Gregification/cse-labs/cse3442 embedded 1/readme.txt

cse3442 Embedded Systems 1, Professor Losh
fall2024,
