Gregification/cse-labs/homelab/kicad/README.txt

sources & breif instructions for everything in the libraries folder
	clone the github / gitlab ones

https://github.com/Digi-Key/digikey-kicad-library
https://gitlab.com/kicad/libraries/kicad-symbols
https://gitlab.com/kicad/libraries/kicad-footprints
