Gregification/cse-labs/cse4352/cse4352_spring2025_project1/src/uart_interface/readme.txt

the files in the uart interface folder are baselined off my (George Boone, 1002055713) embedded 1 lab 4.
