Gregification/cse-labs/homelab/mspm0l1306fiddle/SD ADC logger/src/FatFs/readme.txt

FatFs is a storage interface library.
	web page :		http://elm-chan.org/fsw/ff/
		
Version used : FatFs Module Source Files R0.15

this is a port of FatFs to the MSPM0L1306 MCU.

SD spi info : http://elm-chan.org/docs/mmc/mmc_e.html#spimode
	- CS active low
	- MOSI idle high
	- MISO idle high
	- CLK idle low
