Gregification/cse-labs/cse3341 digital logic design 2/dld2_lab5/cse3341_fall2024_lab5_GeorgeBoone.pdf

CSE 3341 | George Boone 1002055713 | submitted 10/18/2024

# Lab 5 report

## Contents

“Check your understanding” | 1
Simulation Results (8 bit) | 1
Test Results (5 bit) | 4
Pin Assignments | 7
Verilog Code | 10

Note : if you are to build the Quartus project there is a “N” macro defined at the top of the “lab5.sv” file, changing that changes the number of bits handled. E.g : “`define N 8” for 8 bit.

## “Check your understanding”

A : The circuit uses the fact that taking the 2’s complement of a number gets its negative value to find the difference, then because the highest carryout indicates A is less than B and so the result is negative, another 2’s comp conversion can be done to flip the sign of the negative result.

B : cout high indicates value A was less than value B. since the carries are effectively ‘borrows’ so it's just the same as having an extra ‘borrow’. cout low indicates A is greater than B since it was able to satisfy all the ‘borrows’.

## Simulation Results (8 bit)

context: A & B values are input from switches, loaded on button press. Switch 9 is held high to show results, but is not part of the input value. Red LED9 indicates Cout.

| A | B | R = | A - B | | Cout
a | 01010101 | 10101010 | 01010101 | 0
b | 01111111 | 00000001 | 01111110 | 1
c | 01111111 | 11111111 | 10000000 | 0
d | 01100110 | 11011101 | 01110111 | 0

e | 11111111 | 00000000 | 11111111 | 1
f | 00000000 | 11111111 | 11111111 | 0
g | 10101010 | 01010101 | 01010101 | 1
h | 11111111 | 11111111 | 00000000 | 1

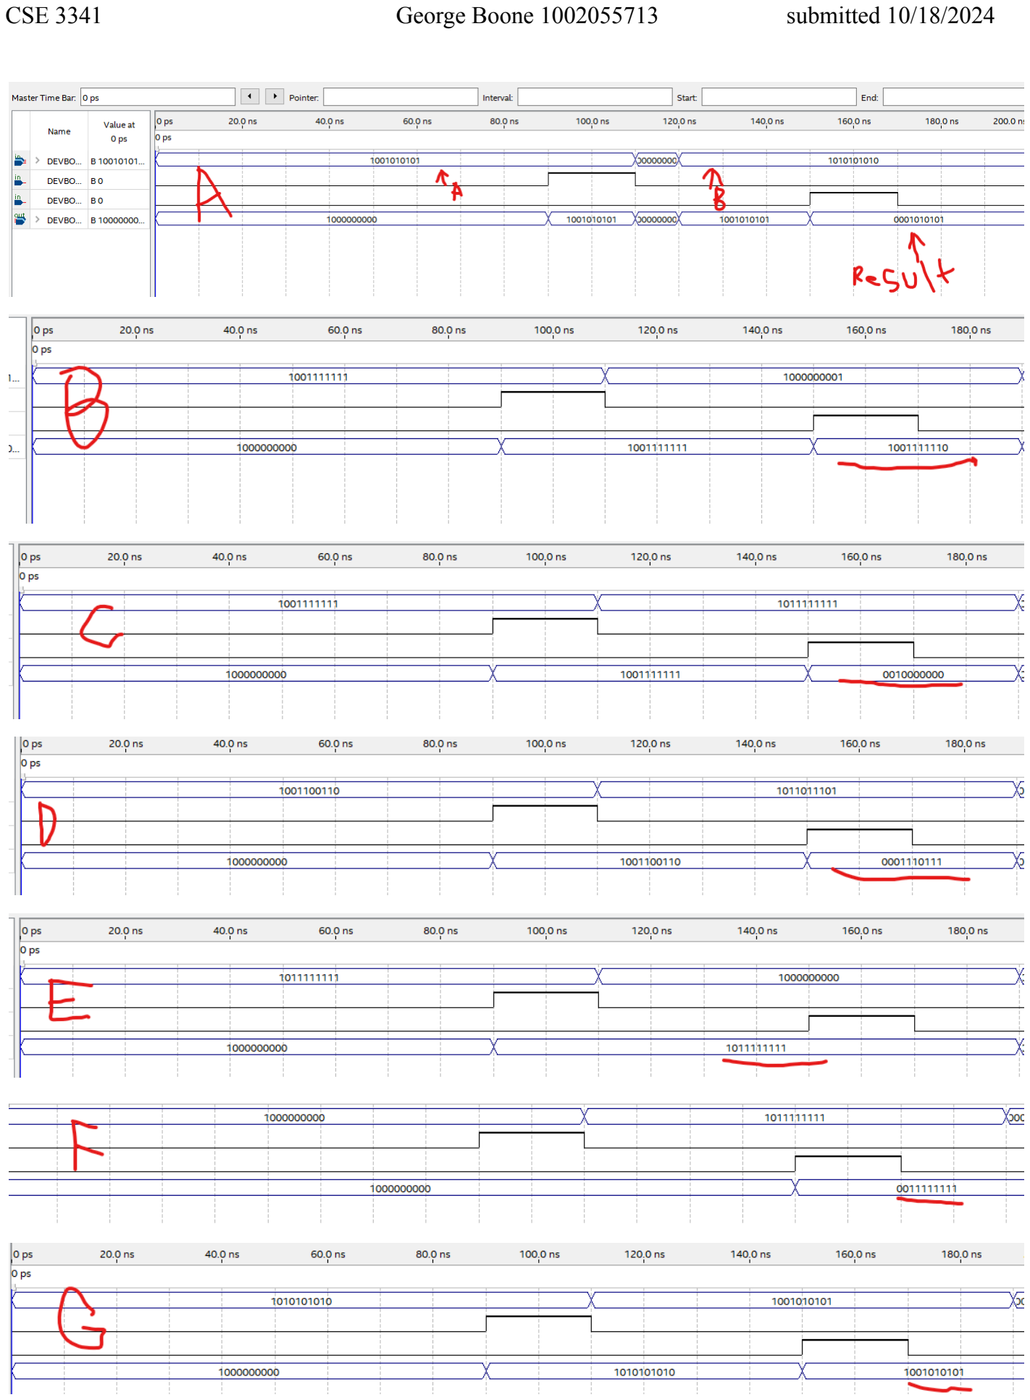
[picture p6: page 3]

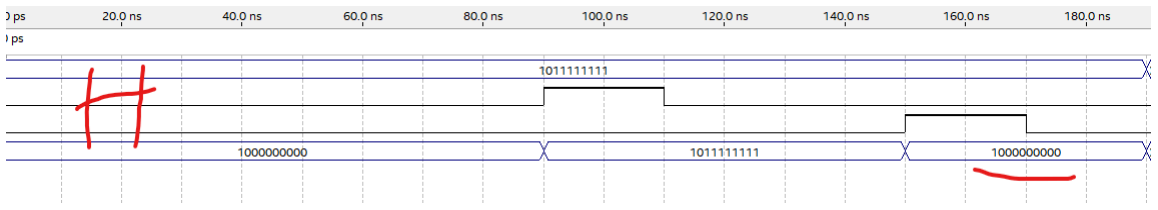
[picture p7: figure]

## Test Results (5 bit)

5-bit results recording : https://youtu.be/OHLeVnUSI3M

| A | B | R = | A - B | | cout
a | 10101 | 01010 | 01011 | 1
b | 01010 | 10101 | 01011 | 0
c | 11111 | 00001 | 11110 | 1
d | 00001 | 11111 | 11110 | 0
e | 10110 | 00000 | 01101 | 1
f | 10110 | 10110 | 00000 | 1

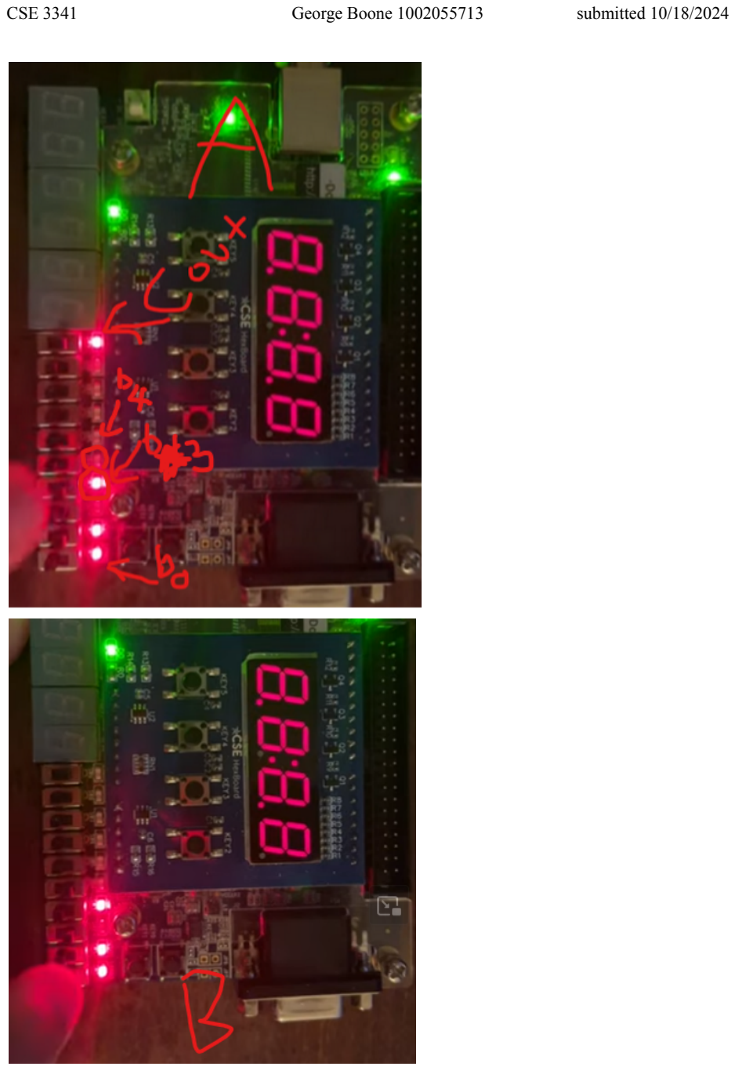
[picture p8: page 5]
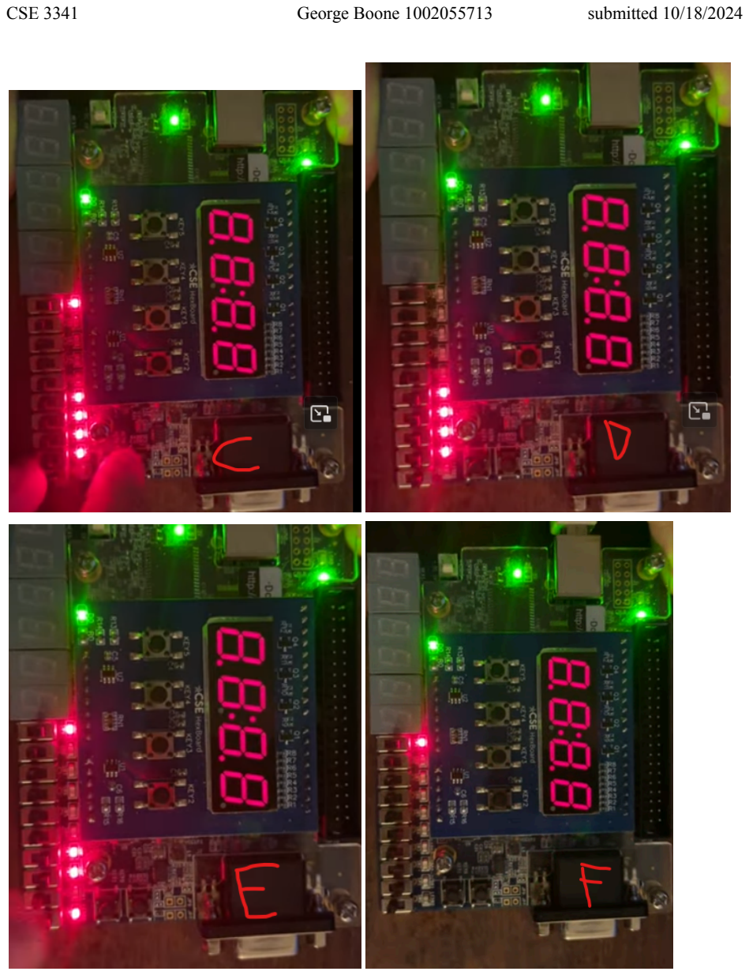
[picture p9: page 6]

## Pin Assignments

effective assignments (from top level of lab module)

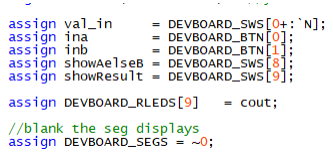
[picture p10: figure]

Actual

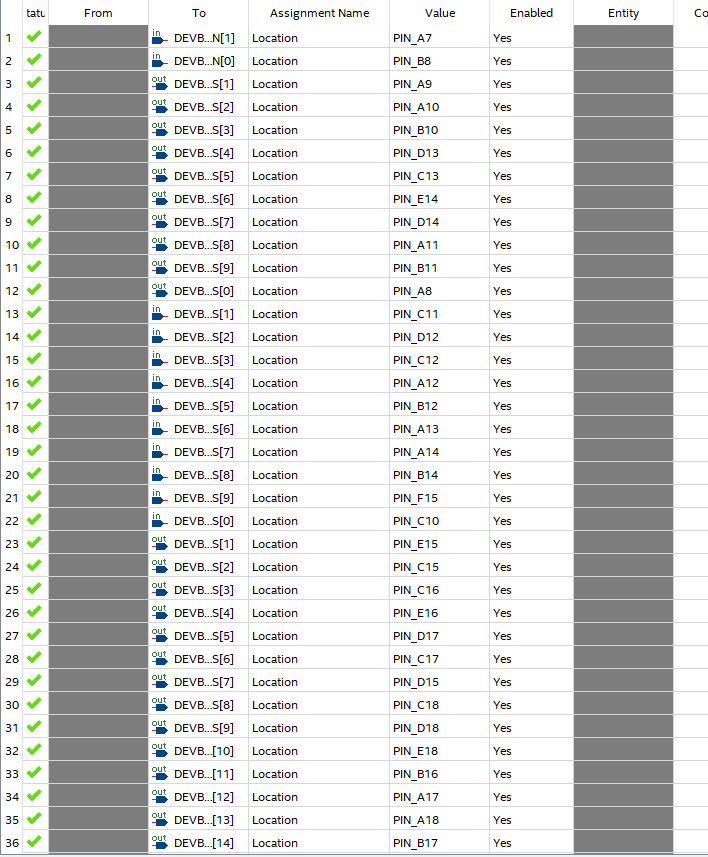
[picture p11: figure]

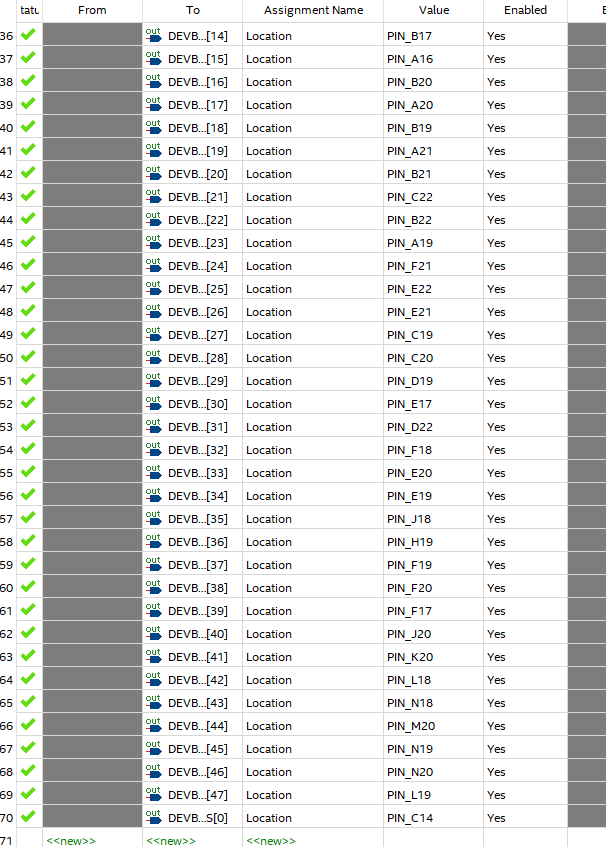
[picture p12: figure]

## Verilog Code

Top level lab

/**
cse3341, digital logic 2, lab 5 George Boone
1002055713

modular exponent subtractor
this module is not part of the logic, it only serves to demo it */

`define N 8

module lab5(
// standard in. i got tired of the assignment editor, see immideatly after wire decelerations for assignments
input [9:0] DEVBOARD_SWS,
input [1:0] DEVBOARD_BTN,
output[9:0] DEVBOARD_RLEDS, output[47:0]DEVBOARD_SEGS
);

//------------------------------------------------------------------------------// INPUT ASSIGMENTS \ EXTERNAL WIRING //------------------------------------------------------------------------------

wire [`N-1:0] val_in;
wire ina, inb;
wire cout;
reg showAelseB, showResult; //yeah

assign val_in = DEVBOARD_SWS[0+:`N];
assign ina | = DEVBOARD_BTN[0];
assign inb | = DEVBOARD_BTN[1];
assign showAelseB = DEVBOARD_SWS[8]; assign showResult = DEVBOARD_SWS[9];

assign DEVBOARD_RLEDS[9] = cout;

//blank the seg displays
assign DEVBOARD_SEGS = ~0;

//------------------------------------------------------------------------------// INTERNAL WIRING
//------------------------------------------------------------------------------reg [`N:0] valA, valB, diff;

always @ (posedge ina)
valA = val_in;

always @ (posedge inb)
valB = val_in;

always @ (showAelseB, showResult) if(showResult == 1)
DEVBOARD_RLEDS[0+:`N] = diff; else if(showAelseB == 1)
DEVBOARD_RLEDS[0+:`N] = valA;
else
DEVBOARD_RLEDS[0+:`N] = valB;

//------------------------------------------------------------------------------
// MODULES
//------------------------------------------------------------------------------

//there is a bug where valA and/or valB are updated when flicking around the switches. // i

//works
// | RCSubtractor(
// | .A(valA),
// | .B(valB),
//
// | .D(diff),
// | .COUT(cout)
// | );

//works
// | BintTwosComp(
// | .BIN(valA),
//
// | .TWOSCOMP(diff),
// | .COUT(cout)
// | );
| ExponentSubtractor#(
| .N(`N)
| )(
| .EA(valA),
| .EB(valB),
| .Cout(cout),
| .ED(diff)
| );

endmodule

Top level exponent subtractor

/**
cse3341, digital logic 2, lab 5
George Boone
1002055713

hardcoded exponent subtractor according to figure 1 of lab document */

module ExponentSubtractor#(
parameter N = 8
)(
input [N-1:0] EA, EB,
output Cout,
output [N-1:0] ED
);

wire [N-1:0] d, invd; // difference, inverted-difference

RCSubtractor #(
.N(N)
) | _rcs | (
.A(EA),
.B(EB),

.D(d),
.COUT(Cout)
);

Mux2t1 #(
.N(N)
) _m2t1 (
.CTRL(Cout),
.A(invd),
.B(d),

.OUT(ED)
);

BintTwosComp #(
.N(N)
) _bttc (

.BIN(d),

.TWOSCOMP(invd)
);

endmodule

Full adder

/**
cse3341, digital logic 2, lab 5 George Boone
1002055713
*/

module FullAdder(
input A, B, CIN,
output S, COUT
);

wire axb;

assign axb = A ^ B;

assign S = axb ^ CIN;
assign COUT = ((axb) & CIN) | (A & B);

endmodule

Ripple carry subtractor

/**
cse3341, digital logic 2, lab 5 George Boone
1002055713

accepts 2 raw binary nums
*/

module RCSubtractor#(
parameter N = 8
)(
input [N-1:0] A, B,
output [N-1:0] D,
output COUT

);

wire [N-1:0] _carries;

assign COUT = _carries[N-1];

// ripple carry design
genvar i;
generate
for(i = N-1; i >= 0; i = i-1) begin : adder_array FullAdder _fa(
.A(A[i]),
.B(~B[i]),
.CIN(i == 0 ? 1 : _carries[i-1]), .S(D[i]),
.COUT(_carries[i])
);
end
endgenerate

endmodule

2 to 1 multiplexer

/**
cse3341, digital logic 2, lab 5 George Boone
1002055713
*/

module Mux2t1#(
parameter N = 8
)(
input CTRL, | // 0:A, 1:B
input [N-1:0] A, B,
output wire [N-1:0] OUT
);

assign OUT = CTRL ? B : A;

endmodule

Binary to 2’s complement converter

/**

cse3341, digital logic 2, lab 5 George Boone
1002055713
*/

module BintTwosComp#(
parameter N = 8
)(
input [N-1:0] BIN,
output reg [N-1:0] TWOSCOMP,

// debug
output reg COUT
);

wire [N-1:0] _carries;

assign COUT = ~_carries[N-1];

// ripple carry design
genvar i;
generate
for(i = N-1; i >= 0; i = i-1) begin : adder_array FullAdder _fa(
.A(~BIN[i]),
.B(0),
.CIN(i == 0 ? 1 : _carries[i-1]), .S(TWOSCOMP[i]),
.COUT(_carries[i])
);
end
endgenerate

endmodule
