Gregification/cse-labs/cse2441/cse2441_labs/FullAdder/Full page photo.pdf

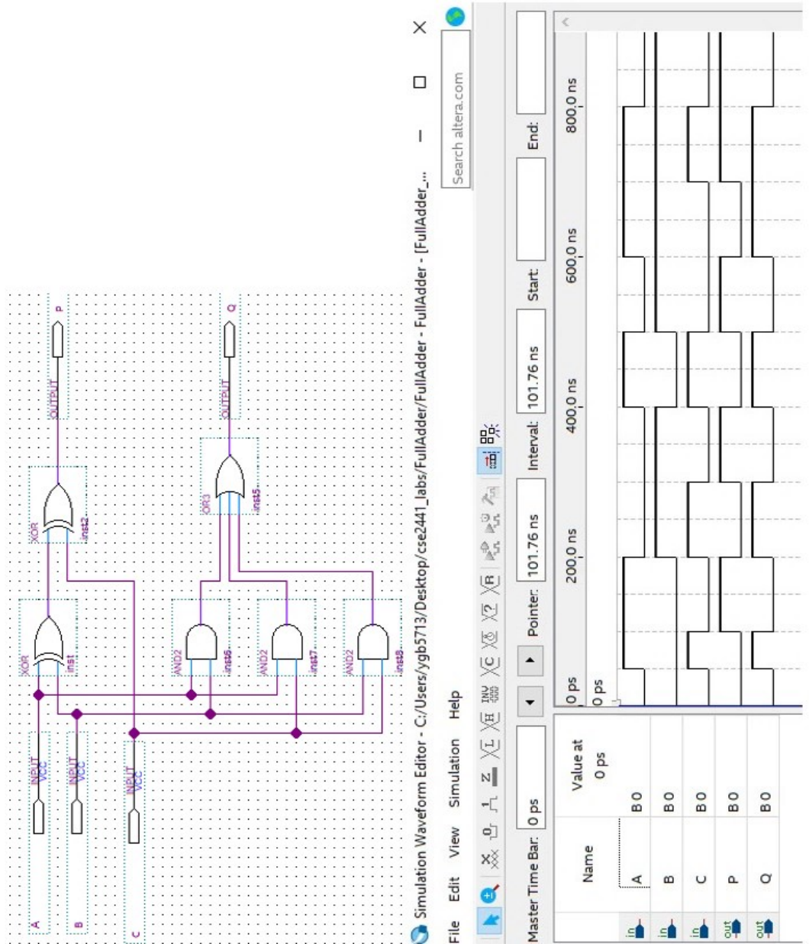
[picture p17: page 1]
