Gregification/cse-labs/cse2441/cse2441_labs/FullAdder/FullAdderFinal.pdf

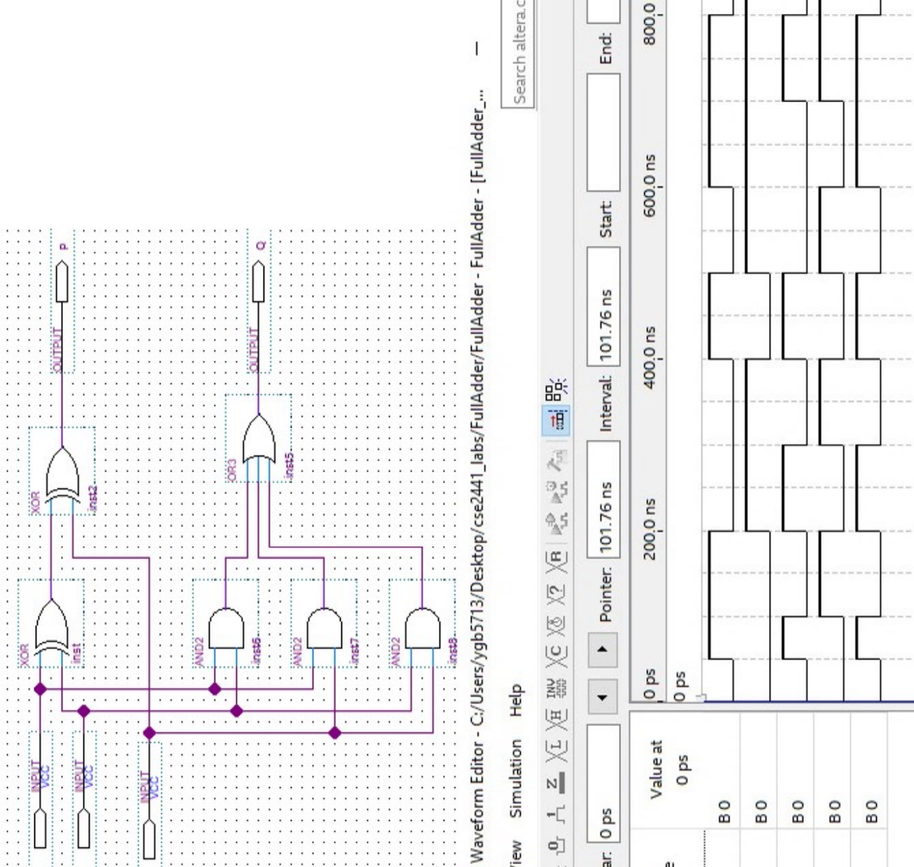
[picture p18: page 1]
