Gregification/cse-labs/cse2441/cse2441_labs/lab3/final.pdf

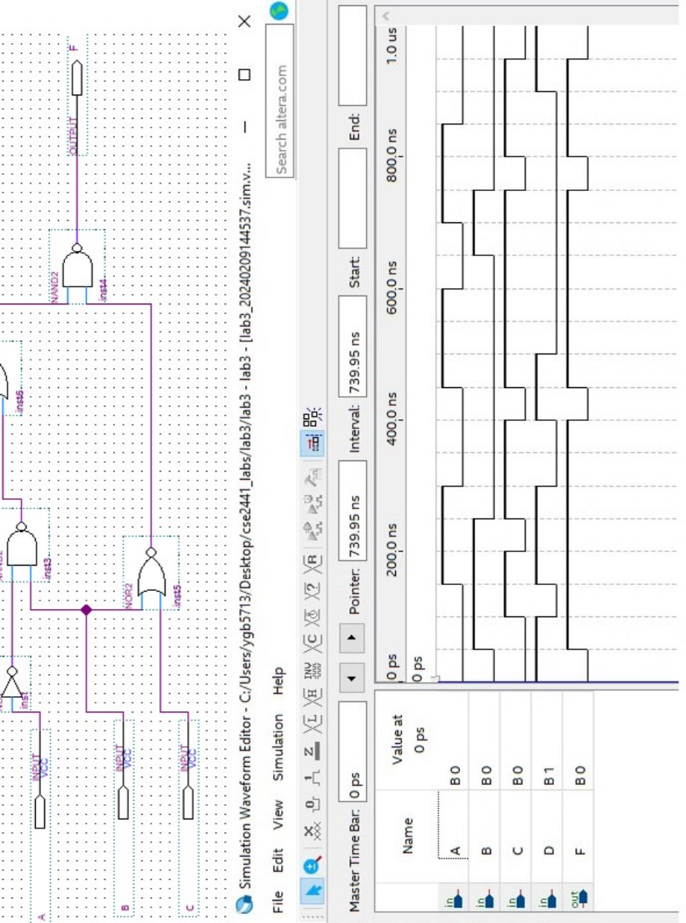
[picture p19: page 1]
