Gregification/cse-labs/cse2441/cse2441_labs/lab3/Full page photo.pdf

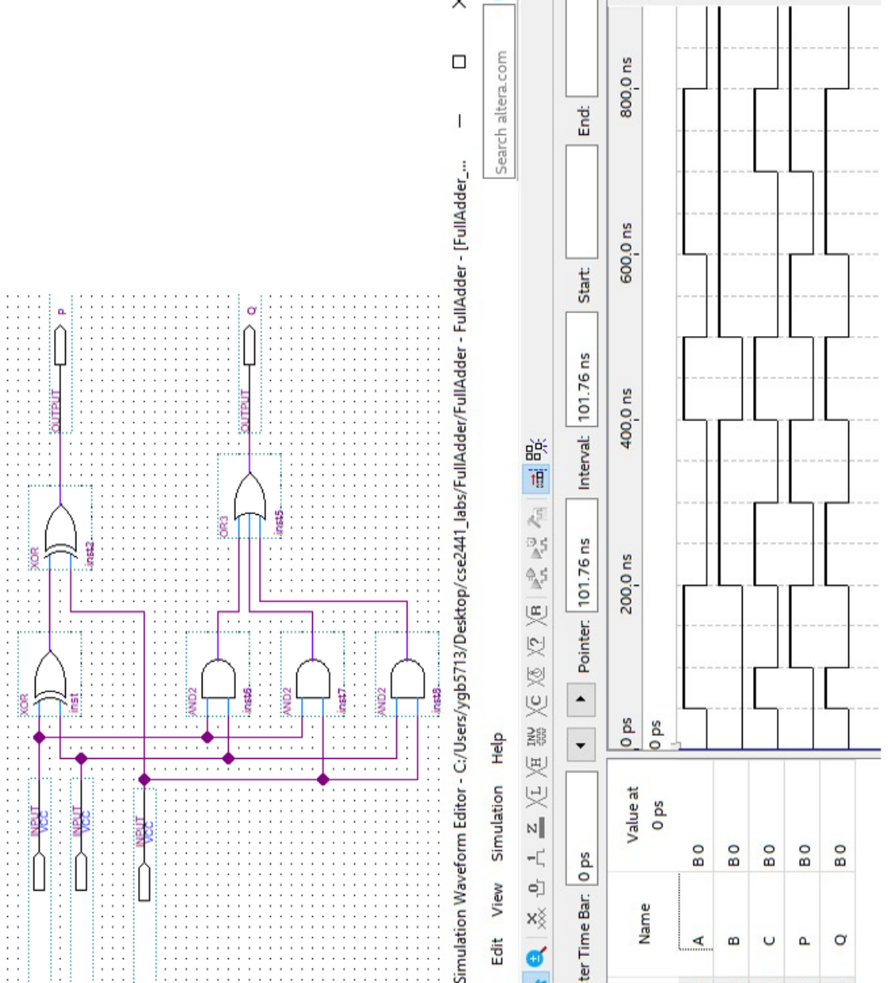
[picture p20: page 1]
