Gregification/cse-labs/cse2441/cse2441_labs/lab3/Lab3Finnal.pdf

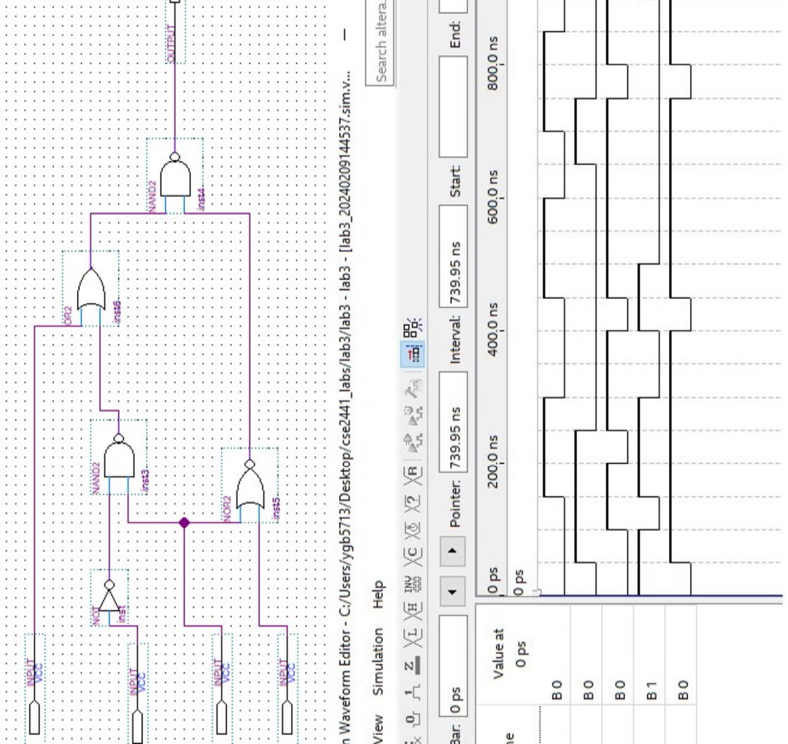
[picture p21: page 1]
