Gregification/cse-labs/cse2441/cse2441_labs/RippleCarryAdder/RippleCarryAdder-final.pdf

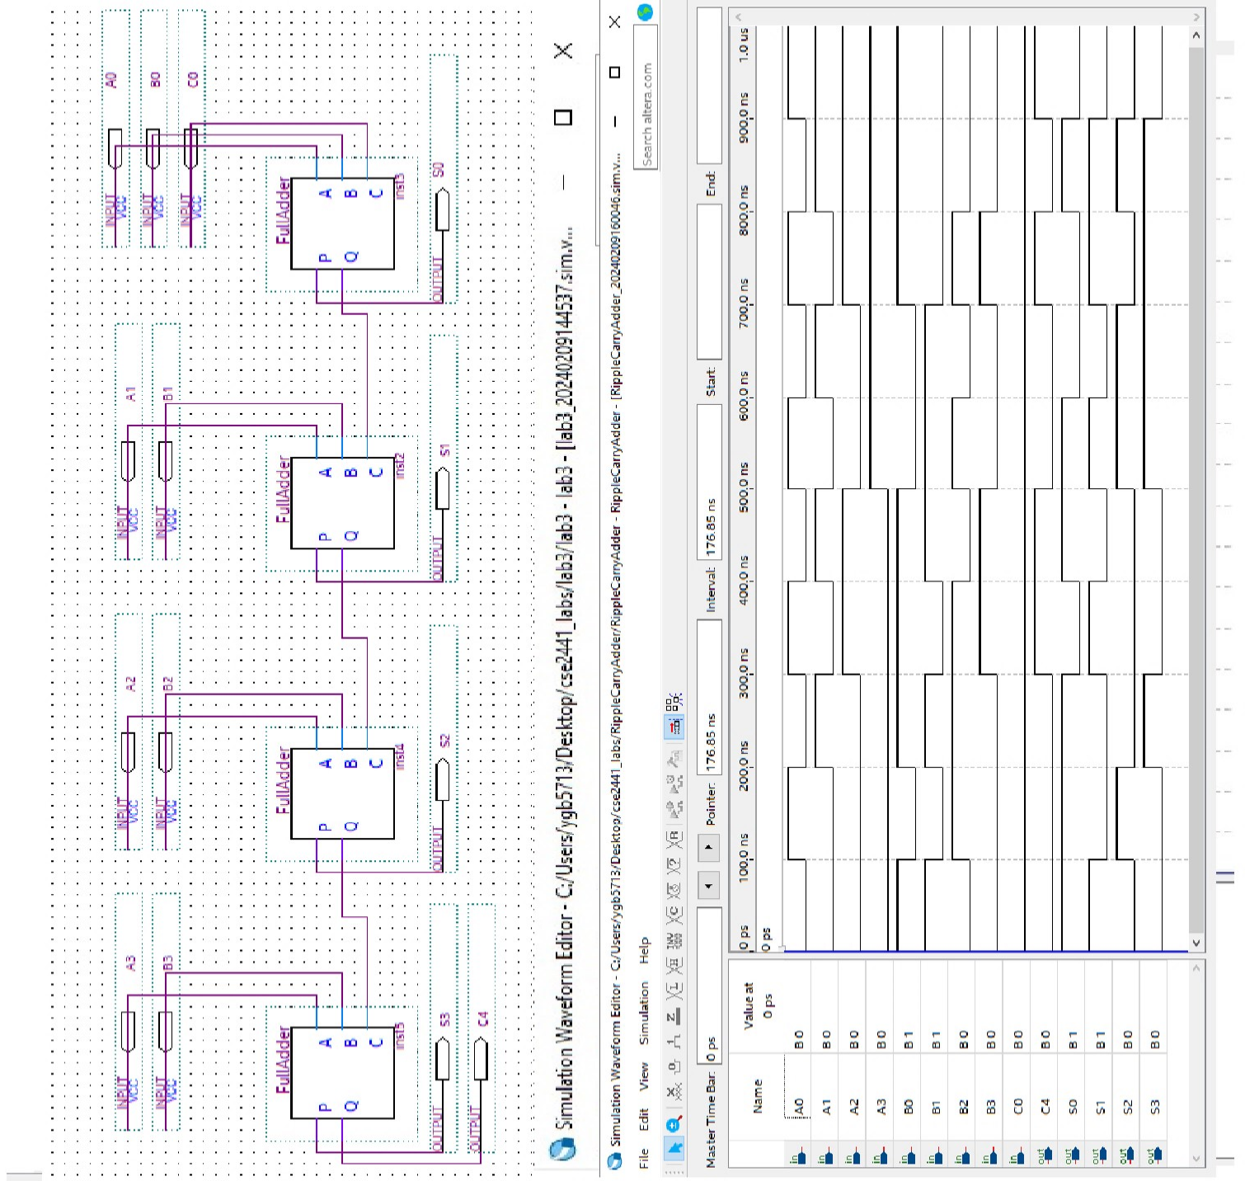
[picture p22: page 1]
