Gregification/cse-labs/cse2441/cse2441_labs/lab6/part1/part1final.pdf

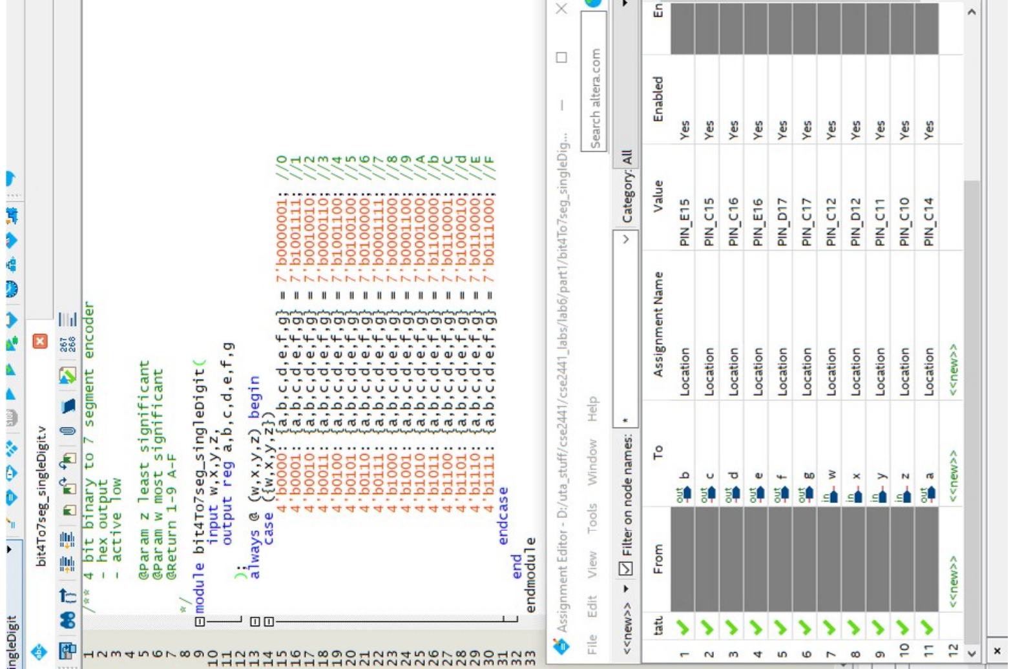
[picture p23: page 1]
