Gregification/cse-labs/cse2441/cse2441_labs/lab6/part2/part2final.pdf

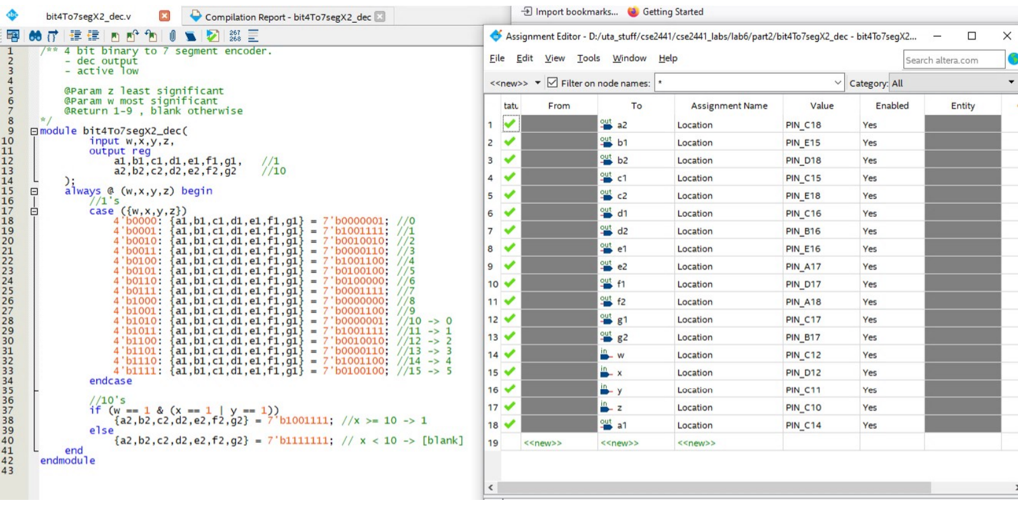
[picture p24: page 1]
