Gregification/cse-labs/cse2441/cse2441_labs/lab6/part3/part3final.pdf

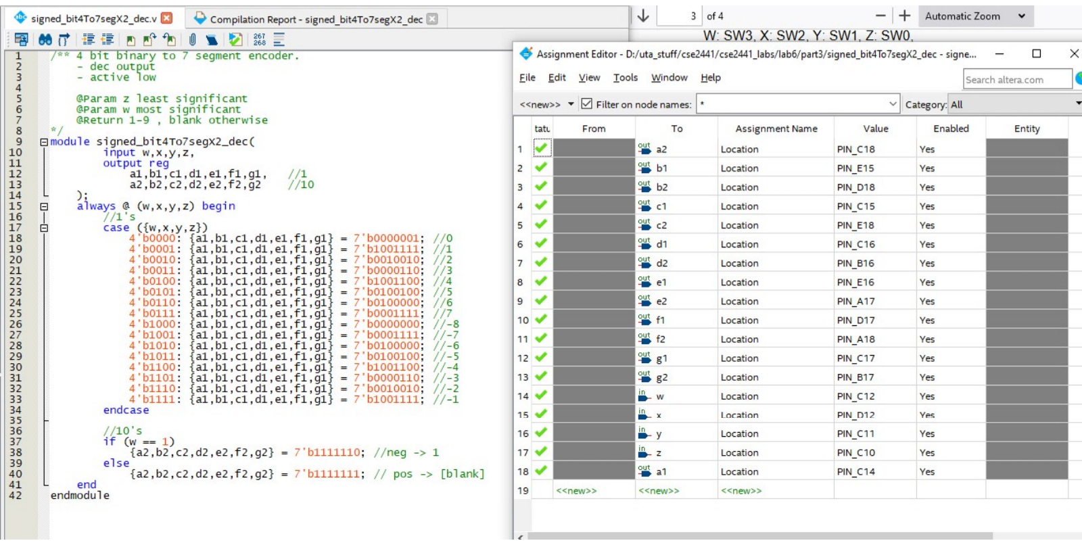
[picture p25: page 1]
