Gregification/cse-labs/cse2441/cse2441_labs/FullAdder/final.png

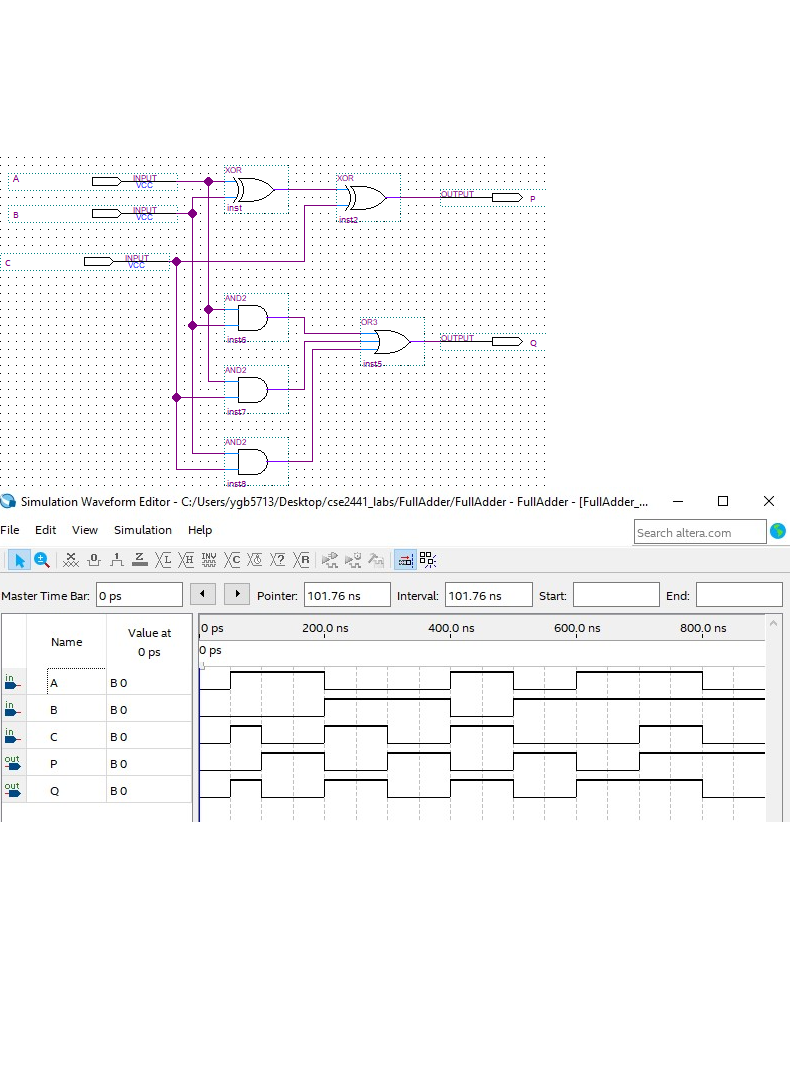
cse2441/cse2441_labs/FullAdder/final.png
