Gregification/cse-labs/cse2441/cse2441_labs/FullAdder/FullAdder-waveform.png

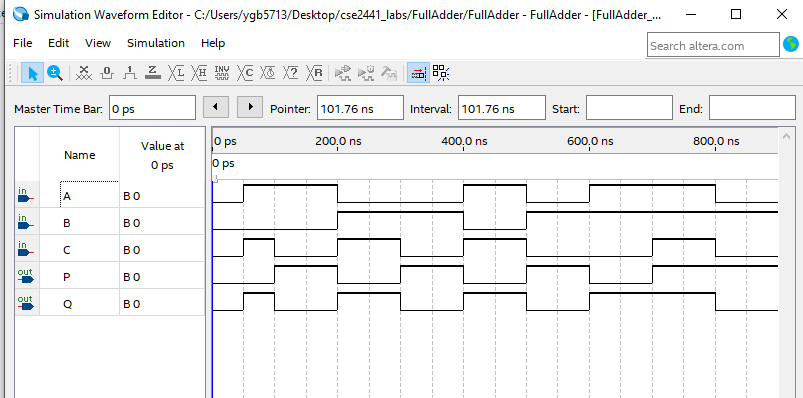
cse2441/cse2441_labs/FullAdder/FullAdder-waveform.png
