Gregification/cse-labs/cse2441/cse2441_labs/lab3/final.png

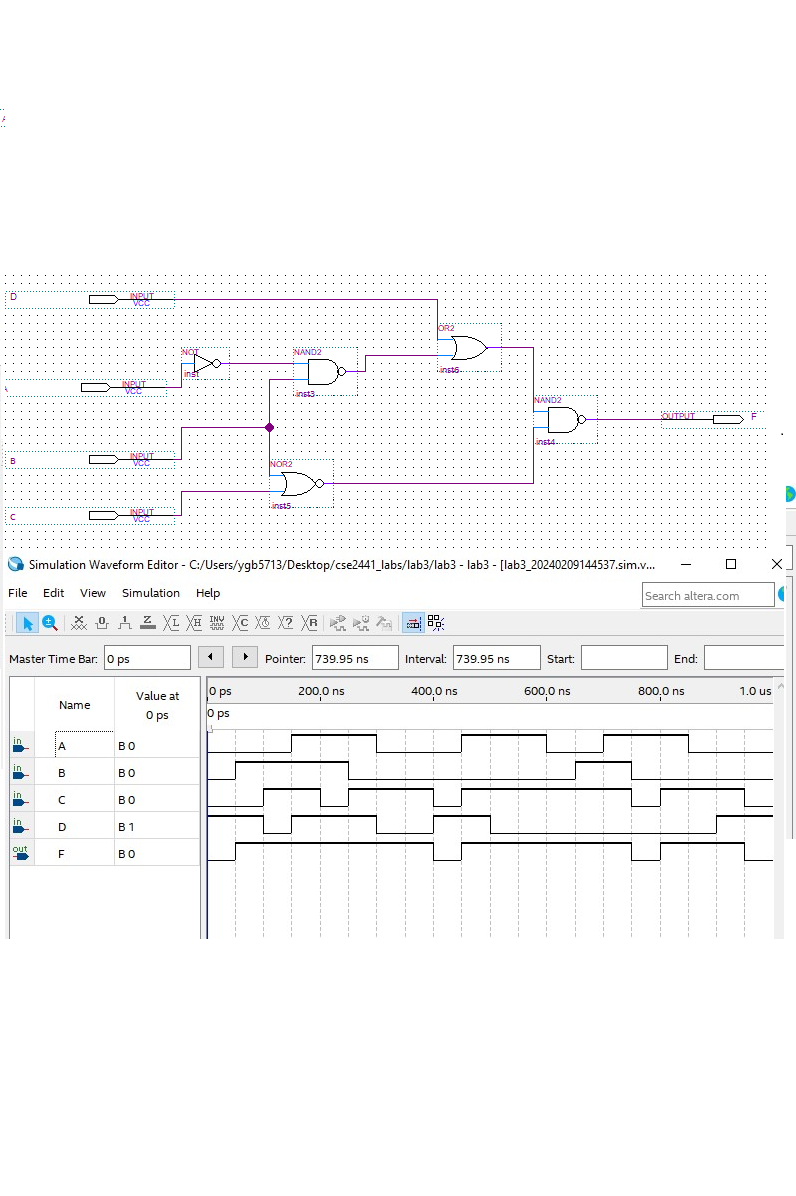
cse2441/cse2441_labs/lab3/final.png
