Gregification/cse-labs/cse2441/cse2441_labs/lab3/Lab3-output.png

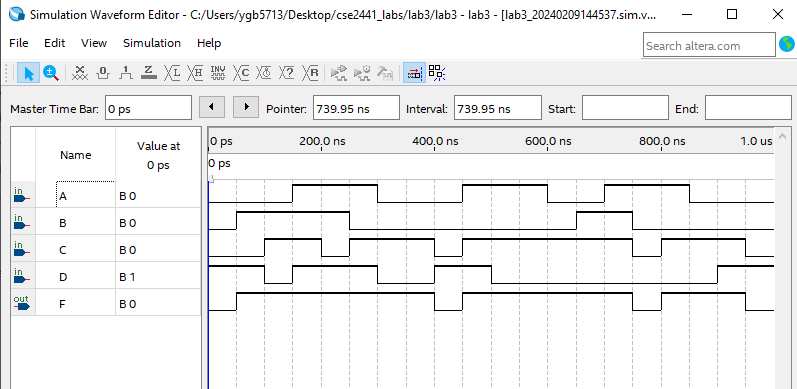
cse2441/cse2441_labs/lab3/Lab3-output.png
