Gregification/cse-labs/cse2441/cse2441_labs/lab6/part1/part1proof.png

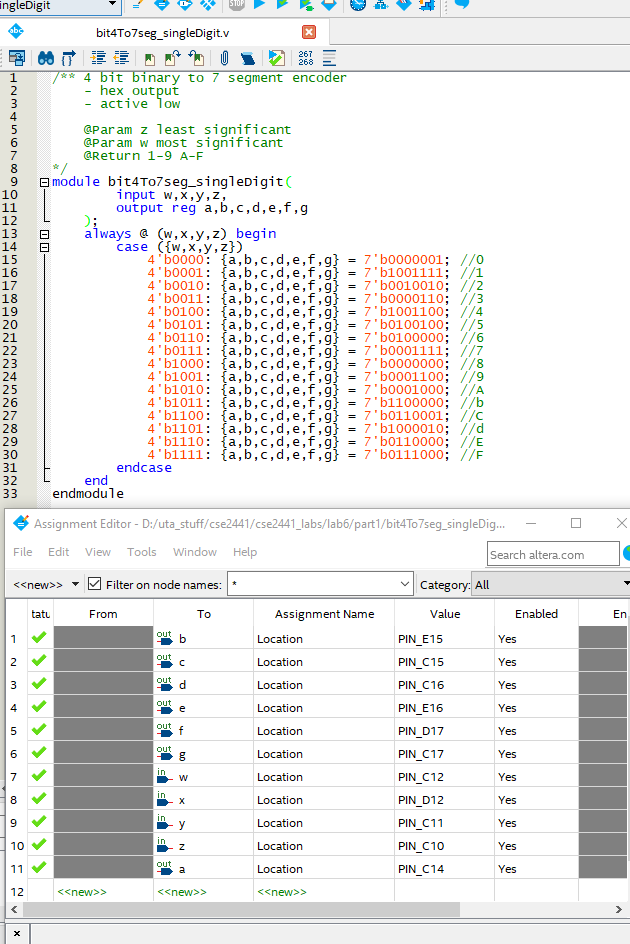
cse2441/cse2441_labs/lab6/part1/part1proof.png
