Gregification/cse-labs/cse2441/cse2441_labs/lab7/question3/proof.png

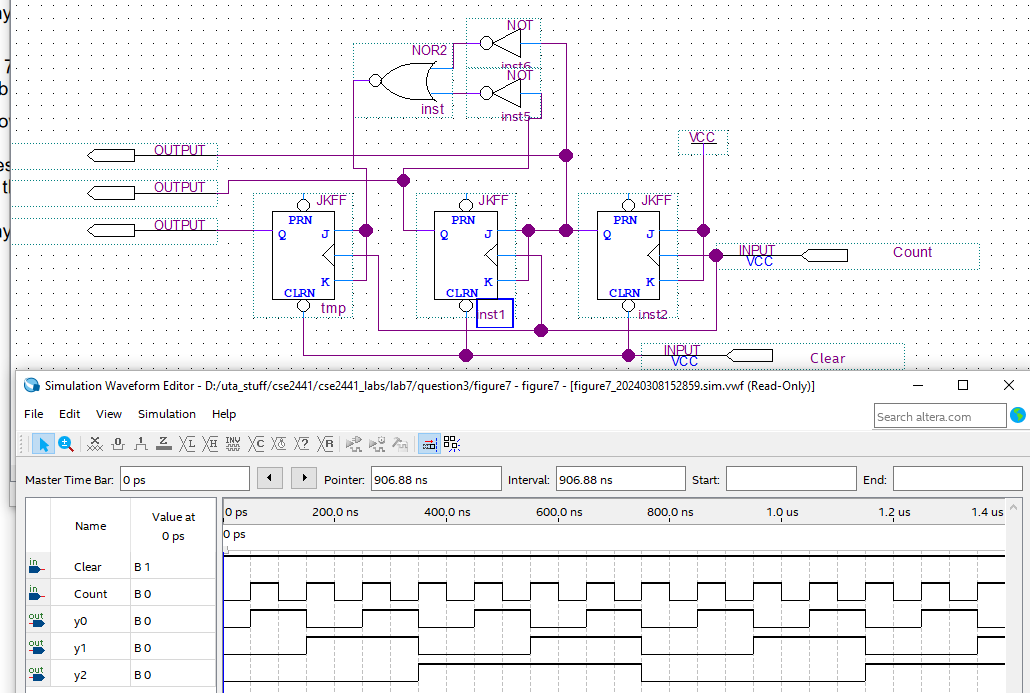
cse2441/cse2441_labs/lab7/question3/proof.png
