Gregification/cse-labs/cse2441/cse2441_labs/RippleCarryAdder/RippleCarryAdder-final.png

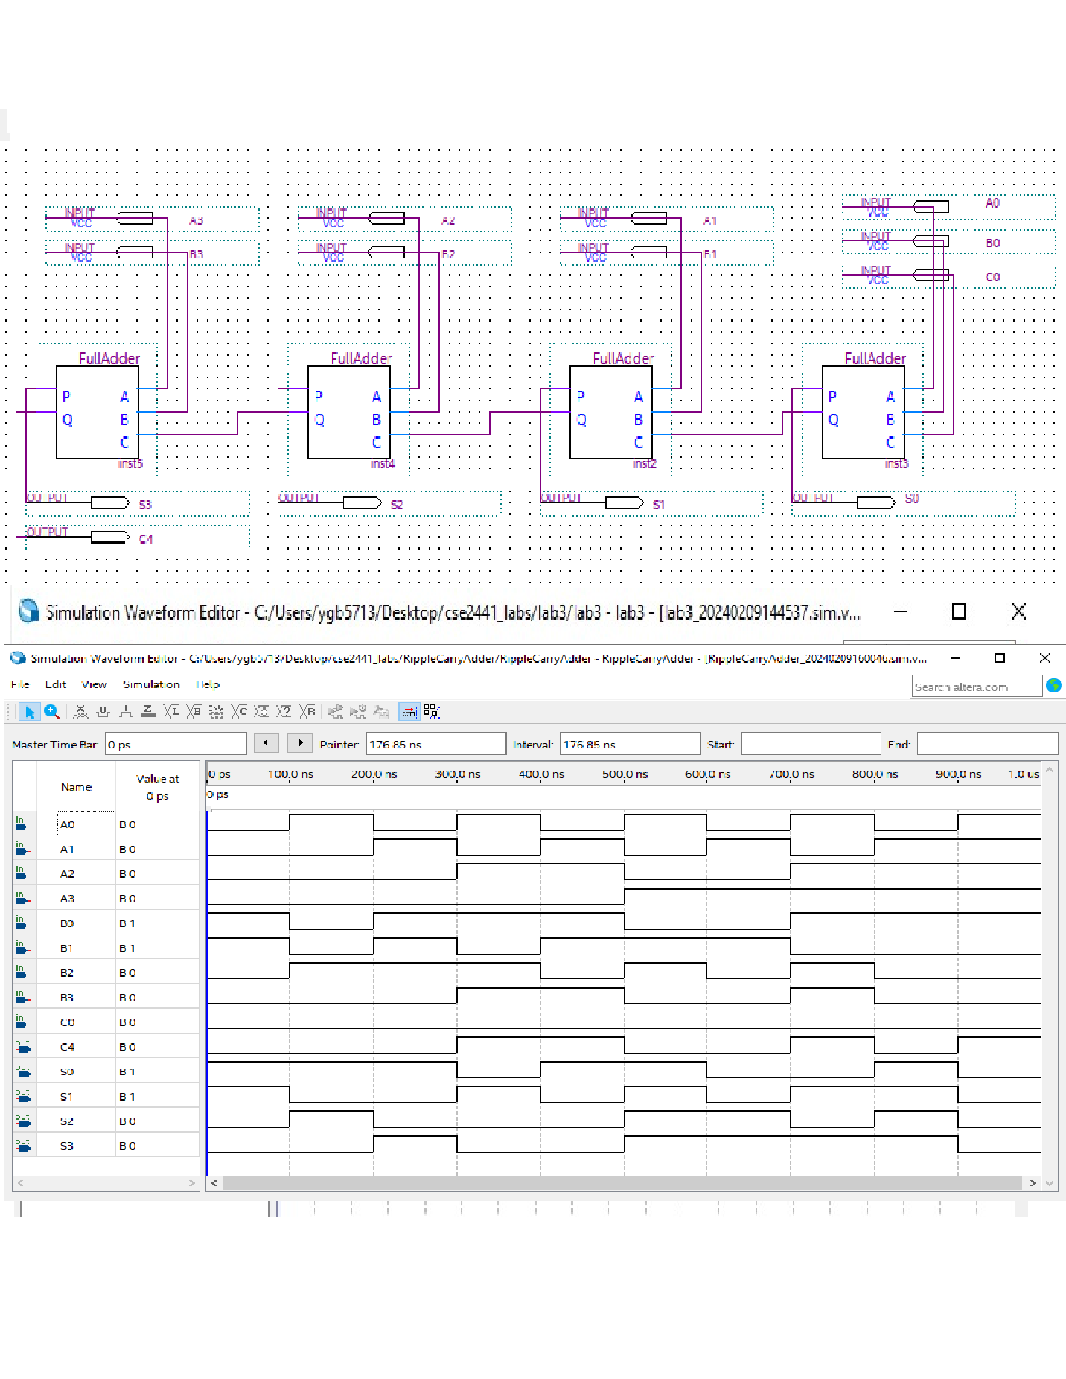
cse2441/cse2441_labs/RippleCarryAdder/RippleCarryAdder-final.png
