Gregification/cse-labs/cse3341 digital logic design 2/dld2_lab3/lab report pics/RTL_GroupCarryLookaheadAdder.png

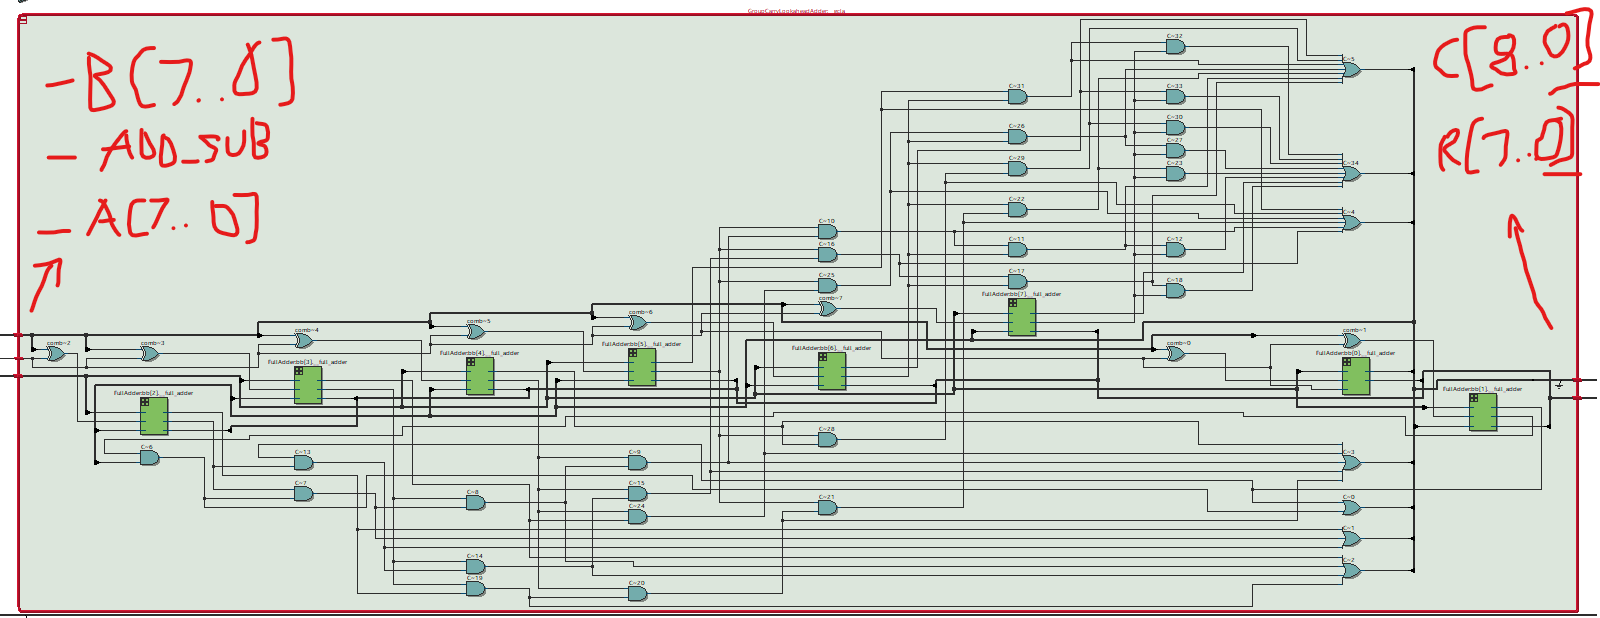
cse3341 digital logic design 2/dld2_lab3/lab report pics/RTL_GroupCarryLookaheadAdder.png
