Gregification/cse-labs/cse4342 embedded 2/lab 5/scope_0.png

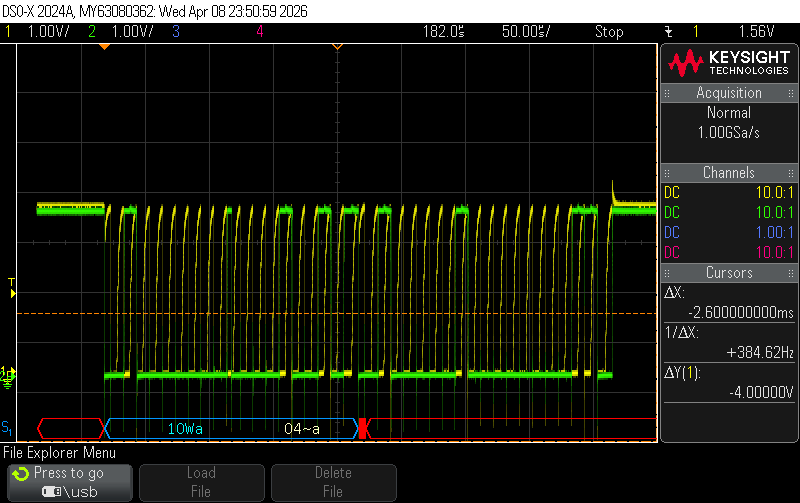
cse4342 embedded 2/lab 5/scope_0.png
