Gregification/cse-labs/(list of files, cad)

Other CAD files:
cse4354 rtos/minimal terminal/Debug/src/main.obj
cse4354 rtos/project/Debug__TI/src/rtos_asm.obj
cse3442 embedded 1/lab1/Debug/src/stop_go.obj
cse4354 rtos/project/Debug__TI/src/common.obj
cse4354 rtos/project/Debug__TI/tm4c123gh6pm_startup_ccs.obj
cse3442 embedded 1/lab1/Debug/src/clock.obj
