Gregification/cse-labs/homelab/kicad/digikeytraning/digikeytraning.kicad_pcb

## KiCad design homelab/kicad/digikeytraning/digikeytraning.kicad_pcb (2024-09-12)

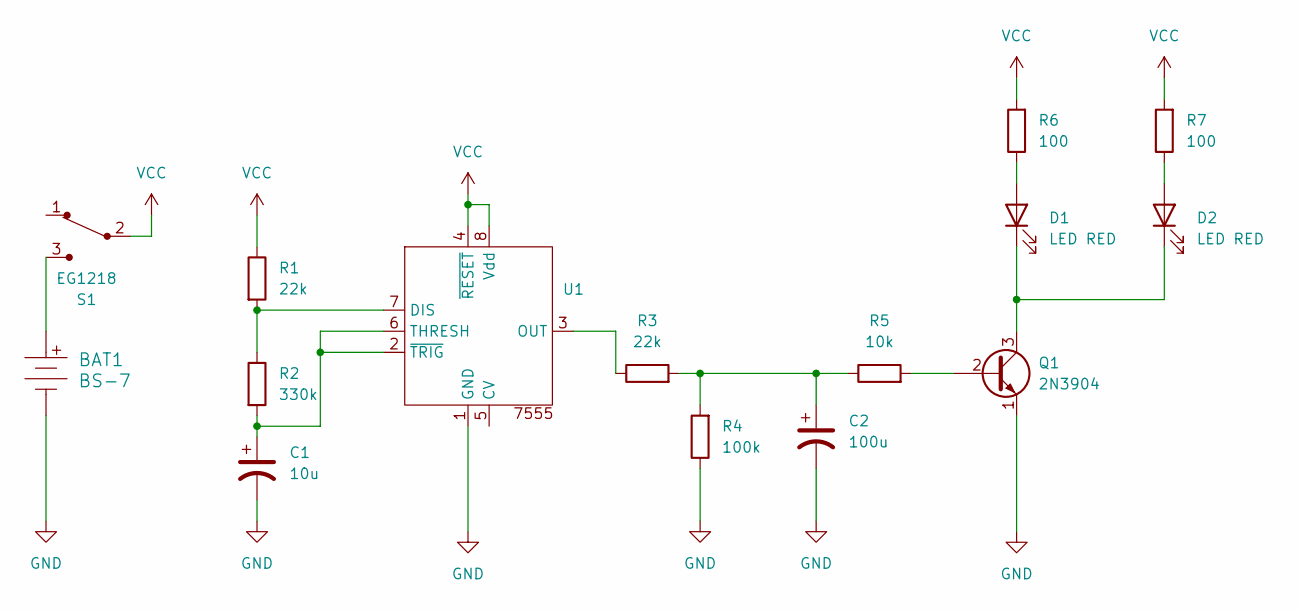
[picture p45: schematic digikeytraning.kicad_sch, 555 badge]

Parts:
BAT1: BS-7; Battery_Holder_Coin_2032_BS-7; MPN BS-7; Digi-Key_PN BS-7-ND
C1: 10u; CP_Radial_D6.3mm_P2.50mm
C2: 100u; CP_Radial_D6.3mm_P2.50mm
D1, D2: LED RED; LED_D3.0mm
Q1: 2N3904; TO-92-3
R1, R3: 22k; R_Axial_DIN0207_L6.3mm_D2.5mm_P7.62mm_Horizontal
R2: 330k; R_Axial_DIN0207_L6.3mm_D2.5mm_P7.62mm_Horizontal
R4: 100k; R_Axial_DIN0207_L6.3mm_D2.5mm_P7.62mm_Horizontal
R5: 10k; R_Axial_DIN0207_L6.3mm_D2.5mm_P7.62mm_Horizontal
R6, R7: 100; R_Axial_DIN0207_L6.3mm_D2.5mm_P7.62mm_Horizontal
S1: EG1218; Switch_Slide_11.6x4mm_EG1218; MPN EG1218; Digi-Key_PN EG1903-ND
U1: ICM7555-PDIP

Connections:
GND: BAT1.Neg, C1.2, C2.2, Q1.1 (E), R4.1, U1.1 (GND)
unnamed: BAT1.Pos, S1.3
unnamed: C2.1, R3.2, R4.2, R5.1
unnamed: D1.2 (A), R6.1
unnamed: D1.1 (K), D2.1 (K), Q1.3 (C)
unnamed: D2.2 (A), R7.1
unnamed: Q1.2 (B), R5.2
unnamed: R1.2, R2.1, U1.7 (DIS)
unnamed: R3.1, U1.3 (OUT)
unnamed: C1.1, R2.2, U1.2 (~TRIG), U1.6 (THRESH)
VCC: R1.1, R6.2, R7.2, S1.2, U1.4 (~RESET), U1.8 (Vdd)

Board: 2 copper layers, 15 parts (0 on the bottom side), 11 nets, no tracks yet.
