Gregification/cse-labs/homelab/mspm0l1306fiddle/dinky remote/src/core/main.cpp

/*
 * main.cpp
 *
 *  Created on: May 26, 2025
 *      Author: turtl
 */
/*
 * LTC6803? more like LT-chit6803. bbq BQ79616
 * main.seapeapea
 */

#include "system.hpp"

#include <FreeRTOS.h>
#include <task.h>

int main(void)
{
    vTaskStartScheduler();
}


#if (configCHECK_FOR_STACK_OVERFLOW)
/*
     *  ======== vApplicationStackOverflowHook ========
     *  When stack overflow checking is enabled the application must provide a
     *  stack overflow hook function. This default hook function is declared as
     *  weak, and will be used by default, unless the application specifically
     *  provides its own hook function.
     */
#if defined(__IAR_SYSTEMS_ICC__)
__weak void vApplicationStackOverflowHook(
    TaskHandle_t pxTask, char *pcTaskName)
#elif (defined(__TI_COMPILER_VERSION__))
#pragma WEAK(vApplicationStackOverflowHook)
void vApplicationStackOverflowHook(TaskHandle_t pxTask, char *pcTaskName)
#elif (defined(__GNUC__) || defined(__ti_version__))
void __attribute__((weak))
vApplicationStackOverflowHook(TaskHandle_t pxTask, char *pcTaskName)
#endif
{
    /* default to spin upon stack overflow */
    while (1) {
    }
}
#endif
