Gregification/cse-labs/cse3442 embedded 1/lab1/src/stop_go.c

// Stop Go C Example (Basic)
// Jason Losh

//-----------------------------------------------------------------------------
// Hardware Target
//-----------------------------------------------------------------------------

// Target Platform: EK-TM4C123GXL Evaluation Board
// Target uC:       TM4C123GH6PM
// System Clock:    40 MHz

// Hardware configuration:
// Red LED:
//   PF1 drives an NPN transistor that powers the red LED
// Green LED:
//   PF3 drives an NPN transistor that powers the green LED
// Pushbutton:
//   SW1 pulls pin PF4 low (internal pull-up is used)

//-----------------------------------------------------------------------------
// Device includes, defines, and assembler directives
//-----------------------------------------------------------------------------

#include <stdint.h>
#include <stdbool.h>
#include "clock.h"
#include "tm4c123gh6pm.h"

// PortF masks
#define GREEN_LED_MASK 8
#define RED_LED_MASK 2
#define PUSH_BUTTON_MASK 16

//-----------------------------------------------------------------------------
// Subroutines
//-----------------------------------------------------------------------------

// Blocking function that returns only when SW1 is pressed
void waitPbPress(void)
{
	while(GPIO_PORTF_DATA_R & PUSH_BUTTON_MASK);
}

// Initialize Hardware
void initHw(void)
{
    // Initialize system clock to 40 MHz
    initSystemClockTo40Mhz();

    // Enable clocks
    SYSCTL_RCGCGPIO_R |= SYSCTL_RCGCGPIO_R5;
    _delay_cycles(3);

    // Configure LED and pushbutton pins
    GPIO_PORTF_DIR_R |= GREEN_LED_MASK | RED_LED_MASK;   // bits 1 and 3 are outputs, other pins are inputs
    GPIO_PORTF_DIR_R &= ~PUSH_BUTTON_MASK;               // bit 4 is an input
    GPIO_PORTF_DEN_R |= PUSH_BUTTON_MASK | GREEN_LED_MASK | RED_LED_MASK;
                                                         // enable LEDs and pushbuttons
    GPIO_PORTF_PUR_R |= PUSH_BUTTON_MASK;                // enable internal pull-up for push button
}

//-----------------------------------------------------------------------------
// Main
//-----------------------------------------------------------------------------

int main(void)
{
	// Initialize hardware
	initHw();

    // Turn off green LED, turn on red LED
    GPIO_PORTF_DATA_R &= ~GREEN_LED_MASK;
    GPIO_PORTF_DATA_R |= RED_LED_MASK;

    // Wait for PB press
    waitPbPress();

    // Turn off red LED, turn on green LED
    GPIO_PORTF_DATA_R &= ~RED_LED_MASK;
    GPIO_PORTF_DATA_R |= GREEN_LED_MASK;

    // Endless loop
    while(true);
}
