Gregification/cse-labs/cse4355 mechatronics/lab6. Thermocoupler Measurements/src/Thermocouple_K_LUT.c

/*
 * Thermocouple_K_LUT.c
 *
 *  Created on: Nov 3, 2025
 *      Author: turtl
 */

#include "Thermocouple_K_LUT.h"
#include <math.h>

float tcV2C_K(int32_t uV){
    int32_t i_upper = 0;
    while (i_upper < TCC2V_K_LEN && TCC2V_K[i_upper] <= uV) {
        i_upper++;
    }

    // if idx == 0, return lowest index -270F
    if (i_upper == 0) {
        return -270.0f;
    }

    // if idx == max, return highest index
    if (i_upper == TCC2V_K_LEN) {
        return (float)(TCC2V_K_LEN - 1) - 270.0f;
    }

    int32_t i_lower = i_upper - 1;

    float V_lower = (float)TCC2V_K[i_lower];
    float V_upper = (float)TCC2V_K[i_upper];
    float V_input = (float)uV;

    float Temp_lower = (float)i_lower - 270.0f;
    float Temp_upper = (float)i_upper - 270.0f; // This is just Temp_lower + 1.0f


    // Get the denominator (range of voltages)
    float V_range = V_upper - V_lower;

    // Avoid division by zero if table entries are identical
    if (V_range <= 0.0f) {
        return Temp_lower;
    }

    // Get the fractional distance of our input voltage within that range
    float fraction = (V_input - V_lower) / V_range;

    // Apply that same fraction to the temperature range
    float Temp_range = Temp_upper - Temp_lower;

    return Temp_lower + (fraction * Temp_range) + 20.0;
}

float tcC2V_K(float degC){
    // Calculate the floating-point index based on the -270C offset
    float base_temp_idx = degC + 270.0f;

    // Find the lower and upper integer indices
    int32_t i_lower = (int32_t)floorf(base_temp_idx);
    int32_t i_upper = i_lower + 1;

    // Handle out-of-bounds requests
    if (i_lower < 0) {
        return (float)TCC2V_K[0]; // Return lowest voltage
    }
    if (i_upper >= TCC2V_K_LEN) {
        return (float)TCC2V_K[TCC2V_K_LEN - 1]; // Return highest voltage
    }

    // Get the fractional part of the temperature
    // This is the "distance" between the lower and upper index
    float fraction = base_temp_idx - (float)i_lower;

    // Get the corresponding voltages from the table
    float V_lower = (float)TCC2V_K[i_lower];
    float V_upper = (float)TCC2V_K[i_upper];

    // Linearly interpolate between the two voltages
    return V_lower + (fraction * (V_upper - V_lower))  - 20.0;
}

int32_t const TCC2V_K[] = {
/*-270*/       -6458, -6457, -6456, -6455, -6453, -6452, -6450, -6448, -6446, -6444,
/*-260*/       -6441, -6438, -6435, -6432, -6429, -6425, -6421, -6417, -6413, -6408,
/*-250*/       -6404, -6399, -6393, -6388, -6382, -6377, -6370, -6364, -6358, -6351,
/*-240*/       -6344, -6337, -6329, -6322, -6314, -6306, -6297, -6289, -6280, -6271,
/*-230*/       -6262, -6252, -6243, -6233, -6223, -6213, -6202, -6192, -6181, -6170,
/*-220*/       -6158, -6147, -6135, -6123, -6111, -6099, -6087, -6074, -6061, -6048,
/*-210*/       -6035, -6021, -6007, -5994, -5980, -5965, -5951, -5936, -5922, -5907,
/*-200*/       -5891, -5876, -5861, -5845, -5829, -5813, -5797, -5780, -5763, -5747,

/*-190*/       -5730, -5713, -5695, -5678, -5660, -5642, -5624, -5606, -5588, -5569,
/*-180*/       -5550, -5531, -5512, -5493, -5474, -5454, -5435, -5415, -5395, -5374,
/*-170*/       -5354, -5333, -5313, -5292, -5271, -5250, -5228, -5207, -5185, -5163,
/*-160*/       -5141, -5119, -5097, -5074, -5052, -5029, -5006, -4983, -4960, -4936,
/*-150*/       -4913, -4889, -4865, -4841, -4817, -4793, -4768, -4744, -4719, -4694,
/*-140*/       -4669, -4644, -4618, -4593, -4567, -4542, -4516, -4490, -4463, -4437,
/*-130*/       -4411, -4384, -4357, -4330, -4303, -4276, -4249, -4221, -4194, -4166,
/*-120*/       -4138, -4110, -4082, -4054, -4025, -3997, -3968, -3939, -3911, -3882,
/*-110*/       -3852, -3823, -3794, -3764, -3734, -3705, -3675, -3645, -3614, -3584,
/*-100*/       -3554, -3523, -3492, -3462, -3431, -3400, -3368, -3337, -3306, -3274,

/*-90*/       -3243, -3211, -3179, -3147, -3115, -3083, -3050, -3018, -2986, -2953,
/*-80*/       -2920, -2887, -2854, -2821, -2788, -2755, -2721, -2688, -2654, -2620,
/*-70*/       -2587, -2553, -2519, -2485, -2450, -2416, -2382, -2347, -2312, -2278,
/*-60*/       -2243, -2208, -2173, -2138, -2103, -2067, -2032, -1996, -1961, -1925,
/*-50*/       -1889, -1854, -1818, -1782, -1745, -1709, -1673, -1637, -1600, -1564,
/*-40*/       -1527, -1490, -1453, -1417, -1380, -1343, -1305, -1268, -1231, -1194,
/*-30*/       -1156, -1119, -1081, -1043, -1006, -968, -930, -892, -854, -816,
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
/*1310*/        52759, 52794, 52828, 52863, 52898, 52932, 52967, 53002, 53037, 53071,
/*1320*/        53106, 53140, 53175, 53210, 53244, 53279, 53313, 53348, 53382, 53417,
/*1330*/        53451, 53486, 53520, 53555, 53589, 53623, 53658, 53692, 53727, 53761,
/*1340*/        53795, 53830, 53864, 53898, 53932, 53967, 54001, 54035, 54069, 54104,
/*1350*/        54138, 54172, 54206, 54240, 54274, 54308, 54343, 54377, 54411, 54445,
/*1360*/        54479, 54513, 54547, 54581, 54615, 54649, 54683, 54717, 54751, 54785,
/*1370*/        54819, 54852, 54886,
    };
