Gregification/cse-labs/cse4354 rtos/project/src/common.h

/*
 * common.h
 *
 *  Created on: Aug 24, 2025
 *      Author: turtl
 */

#ifndef SRC_COMMON_H_
#define SRC_COMMON_H_

#include <stdint.h>
#include <stdbool.h>
#include "tm4c123gh6pm.h"

#define BV(X) (1 << (X))                    // Bit Value
#define ARRANDN(ARR) ARR,sizeof(ARR)        // ARRay AND size N
#define SETPIF(PTR, VAL) if(PTR) *(PTR)=(VAL);// SET Pointer IF pointer exists

#define F_CPU 40e6

#define NEWLINE         "\n\r"
#define CLIERROR        "\033[38;2;255;0;0m"
#define CLIHIGHLIGHT    "\033[38;2;255;255;0m"
#define CLIGOOD         "\033[38;2;0;255;0m"
#define CLIYES          "\033[38;2;0;255;255m"
#define CLINO           "\033[38;2;255;0;255m"
#define CLIWARN         "\033[38;2;255;100;0m"
#define CLIRESET        "\033[0m"
#define CLICLEAR        "\033[2J\033[H\033[0m"

#define LED_RED     PORTE,0
#define LED_GREEN   PORTA,4
#define LED_BLUE    PORTF,2
#define LED_ORANGE  PORTA,2
#define LED_YELLOW  PORTA,3

#define BTN_0_I     PORTF,4 // this has a pull up which also powers all other buttons
#define BTN_1_I     PORTC,4
#define BTN_2_I     PORTC,5
#define BTN_3_I     PORTC,6
#define BTN_4_I     PORTC,7
#define BTN_5_I     PORTD,6

#define SW1         PORTF,4
#define SW2         PORTF,0

/** returns 0 if equal */
bool strCmp(const char *, const char *);
void printu32d(uint32_t);
void printu32h(uint32_t);

/* should be the same as whats used in the linker cmd file */
#define FLASH_BASE  0x00000000
#define FLASH_SIZE  0x00040000
#define SRAM_BASE   0x20000000
#define SRAM_SIZE   0x00008000

#endif /* SRC_COMMON_H_ */
