Gregification/cse-labs/cse4352/cse4352_spring2025_project1/src/framework/socket.c

// Socket Library
// Jason Losh

//-----------------------------------------------------------------------------
// Hardware Target
//-----------------------------------------------------------------------------

// Target Platform: -
// Target uC:       -
// System Clock:    -

// Hardware configuration:
// -

//-----------------------------------------------------------------------------
// Device includes, defines, and assembler directives
//-----------------------------------------------------------------------------

#include <stdio.h>
#include "arp.h"
#include "ip.h"
#include "udp.h"
#include "tcp.h"

#define MAX_SOCKETS 5

// ------------------------------------------------------------------------------
//  Globals
// ------------------------------------------------------------------------------

//uint8_t socketCount = 0;
socket sockets[MAX_SOCKETS];

// ------------------------------------------------------------------------------
//  Structures
// ------------------------------------------------------------------------------

//-----------------------------------------------------------------------------
// Subroutines
//-----------------------------------------------------------------------------

void initSockets(void)
{
    uint8_t i;
    for (i = 0; i < MAX_SOCKETS; i++)
        sockets[i].state = TCP_CLOSED;
}

socket * newSocket(void)
{
    uint8_t i = 0;
    socket * s = NULL;
    bool foundUnused = false;
    while (i < MAX_SOCKETS && !foundUnused)
    {
        foundUnused = sockets[i].state == TCP_CLOSED;
        if (foundUnused)
            s = &sockets[i];
        i++;
    }
    return s;
}

void deleteSocket(socket *s)
{
    uint8_t i = 0;
    bool foundMatch = false;
    while (i < MAX_SOCKETS && !foundMatch)
    {
        foundMatch = &sockets[i] == s;
        if (foundMatch)
            sockets[i].state = TCP_CLOSED;
        i++;
    }
}

// Get socket information from a received ARP response message
void getSocketInfoFromArpResponse(etherHeader *ether, socket *s)
{
    arpPacket *arp = (arpPacket*)ether->data;
    uint8_t i;
    for (i = 0; i < HW_ADD_LENGTH; i++)
        s->remoteHwAddress[i] = arp->sourceAddress[i];
    for (i = 0; i < IP_ADD_LENGTH; i++)
        s->remoteIpAddress[i] = arp->sourceIp[i];
}

// Get socket information from a received UDP packet
void getSocketInfoFromUdpPacket(etherHeader *ether, socket *s)
{
    ipHeader *ip = (ipHeader*)ether->data;
    uint8_t ipHeaderLength = ip->size * 4;
    udpHeader *udp = (udpHeader*)((uint8_t*)ip + ipHeaderLength);
    uint8_t i;
    for (i = 0; i < HW_ADD_LENGTH; i++)
        s->remoteHwAddress[i] = ether->sourceAddress[i];
    for (i = 0; i < IP_ADD_LENGTH; i++)
        s->remoteIpAddress[i] = ip->sourceIp[i];
    s->remotePort = ntohs(udp->sourcePort);
    s->localPort = ntohs(udp->destPort);
}

// Get socket information from a received TCP packet
void getSocketInfoFromTcpPacket(etherHeader *ether, socket *s)
{
    ipHeader *ip = (ipHeader*)ether->data;
    uint8_t ipHeaderLength = ip->size * 4;
    tcpHeader* tcp = (tcpHeader*)((uint8_t*)ip + ipHeaderLength);
    uint8_t i;
    for (i = 0; i < HW_ADD_LENGTH; i++)
        s->remoteHwAddress[i] = ether->sourceAddress[i];
    for (i = 0; i < IP_ADD_LENGTH; i++)
        s->remoteIpAddress[i] = ip->sourceIp[i];
    s->remotePort = ntohs(tcp->sourcePort);
    s->localPort = ntohs(tcp->destPort);
}

bool isSocketSame(socket const * a, socket const * b){
    if(!(a && b && a->remoteHwAddress && b->remoteHwAddress && a->remoteIpAddress && b->remoteIpAddress))
        return false;

    uint8_t i;
    for(i = 0; i < IP_ADD_LENGTH + HW_ADD_LENGTH + sizeof(port) * 2; i++)
        if(((uint8_t *)a)[i] != ((uint8_t *)b)[i])
            return false;

    return true;
}
