Gregification/cse-labs/cse2441/verilogFiddle/lab6.v

/**
    seven segment dispaly stuff
*/

//part 1
/** 4 bit binary to 7 segment encoder
    - hex output
    - active low
    
    @Param z least significant
    @Param w most significant
    @Return 1-9 A-F
*/
module bit4To7seg_singleDigit(
        input w,x,y,z,
        output reg a,b,c,d,e,f,g
    );
    always @ (w,x,y,z) begin
        case ({w,x,y,z})
            4'b0000: {a,b,c,d,e,f,g} = 7'b0000001; //0
            4'b0001: {a,b,c,d,e,f,g} = 7'b1001111; //1
            4'b0010: {a,b,c,d,e,f,g} = 7'b0010010; //2
            4'b0011: {a,b,c,d,e,f,g} = 7'b0000110; //3
            4'b0100: {a,b,c,d,e,f,g} = 7'b1001100; //4
            4'b0101: {a,b,c,d,e,f,g} = 7'b0100100; //5
            4'b0110: {a,b,c,d,e,f,g} = 7'b0100000; //6
            4'b0111: {a,b,c,d,e,f,g} = 7'b0001111; //7
            4'b1000: {a,b,c,d,e,f,g} = 7'b0000000; //8
            4'b1001: {a,b,c,d,e,f,g} = 7'b0001100; //9
            4'b1010: {a,b,c,d,e,f,g} = 7'b0001000; //A
            4'b1011: {a,b,c,d,e,f,g} = 7'b1100000; //b
            4'b1100: {a,b,c,d,e,f,g} = 7'b0110001; //C
            4'b1101: {a,b,c,d,e,f,g} = 7'b1000010; //d
            4'b1110: {a,b,c,d,e,f,g} = 7'b0110000; //E
            4'b1111: {a,b,c,d,e,f,g} = 7'b0111000; //F
        endcase
    end
endmodule

//part 2
/** 4 bit binary to 7 segment encoder. 
    - dec output
    - active low

    @Param z least significant
    @Param w most significant
    @Return 1-9 , blank otherwise
*/
module bit4To7segX2_dec(
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
            4'b1111: {a1,b1,c1,d1,e1,f1,g1} = 7'b1001111; //-1
        endcase

        //10's
        if (w == 1)
            {a2,b2,c2,d2,e2,f2,g2} = 7'b1111110; //neg -> 1
        else 
            {a2,b2,c2,d2,e2,f2,g2} = 7'b1111111; // pos -> [blank]
    end
endmodule
