Gregification/cse-labs/cse4355 mechatronics/lab6. Thermocoupler Measurements/src/Thermocouple_K_LUT.h

/*
 * Thermocouple_K_LUT.h
 *
 *  Created on: Nov 3, 2025
 *      Author: turtl
 */

#ifndef SRC_THERMOCOUPLE_K_LUT_H_
#define SRC_THERMOCOUPLE_K_LUT_H_

#include <stdint.h>


float tcV2C_K(int32_t mV);
float tcC2V_K(float degC);

#define TCC2V_K_LEN 1643
/* thermocouple type K, degree celsius to voltage relation
 * starts at -270C, +1C per-array index
 * e.g: 500C => uV = arr[500+270]
 */
extern int32_t const TCC2V_K[TCC2V_K_LEN];


#endif /* SRC_THERMOCOUPLE_K_LUT_H_ */
