Gregification/cse-labs/homelab/tm4c129ncfiddle/BeeMS/src/Core/sys_perf_config.hpp

/*
 * sys_perf_config.hpp
 *
 *  Created on: May 10, 2025
 *      Author: turtl
 */
/*
 * discount device tree
 *      but its in c/cpp, and its only for on chip peripherals.
 *      its just a single place for pin & peripheral changes to make refactoring
 *      easier when we inevitable change something down the line.
 * project specific
 */

#ifndef SRC_CORE_SYS_PERF_CONFIG_HPP_
#define SRC_CORE_SYS_PERF_CONFIG_HPP_





#endif /* SRC_CORE_SYS_PERF_CONFIG_HPP_ */
