Gregification/cse-labs/cse4352/cse4352_spring2025_project1/src/framework/icmp.c

// ICMP Library
// Jason Losh

//-----------------------------------------------------------------------------
// Hardware Target
//-----------------------------------------------------------------------------

// Target Platform: -
// Target uC:       -
// System Clock:    -

// Hardware configuration:
// -

//-----------------------------------------------------------------------------
// Device includes, defines, and assembler directives
//-----------------------------------------------------------------------------

#include <stdio.h>
#include "icmp.h"

// ------------------------------------------------------------------------------
//  Globals
// ------------------------------------------------------------------------------


// ------------------------------------------------------------------------------
//  Structures
// ------------------------------------------------------------------------------

//-----------------------------------------------------------------------------
// Subroutines
//-----------------------------------------------------------------------------

// Determines whether packet is ping request
// Must be an IP packet
bool isPingRequest(etherHeader *ether)
{
    ipHeader *ip = (ipHeader*)ether->data;
    uint8_t ipHeaderLength = ip->size * 4;
    icmpHeader *icmp = (icmpHeader*)((uint8_t*)ip + ipHeaderLength);
    return (ip->protocol == PROTOCOL_ICMP && icmp->type == 8);
}

// Sends a ping request
void sendPingRequest(etherHeader *ether, uint8_t ipAdd[])
{
    // move code here from master icmp lib
}

// Sends a ping response given the request data
void sendPingResponse(etherHeader *ether)
{
    ipHeader *ip = (ipHeader*)ether->data;
    uint8_t ipHeaderLength = ip->size * 4;
    icmpHeader *icmp = (icmpHeader*)((uint8_t*)ip + ipHeaderLength);
    uint8_t i, tmp;
    uint16_t icmp_size;
    uint32_t sum = 0;
    // swap source and destination fields
    for (i = 0; i < HW_ADD_LENGTH; i++)
    {
        tmp = ether->destAddress[i];
        ether->destAddress[i] = ether->sourceAddress[i];
        ether->sourceAddress[i] = tmp;
    }
    for (i = 0; i < IP_ADD_LENGTH; i++)
    {
        tmp = ip->destIp[i];
        ip->destIp[i] = ip ->sourceIp[i];
        ip->sourceIp[i] = tmp;
    }
    // this is a response
    icmp->type = 0;
    // calc icmp checksum
    icmp->check = 0;
    icmp_size = ntohs(ip->length) - ipHeaderLength;
    sumIpWords(icmp, icmp_size, &sum);
    icmp->check = getIpChecksum(sum);
    // send packet
    putEtherPacket(ether, sizeof(etherHeader) + ntohs(ip->length));
}
