Gregification/cse-labs/cse3341 digital logic design 2/dld2_termProject/FullAdder.sv

/**
	cse3341, digital logic 2, term project
	George Boone
	1002055713
	
	a generic full adder
*/

module FullAdder(
		input 	A,
		input 	B,
		input		C,
		
		output 	R,
		output	COUT
	);
	
	wire axb, ac, axbc;
	
	xor(axb, 	A, 	B);
	xor(R,		axb,	C);
	
	and(ab,		A,		B);
	and(axbc,	axb,	C);
	or	(COUT,	axbc,	ab);
	
endmodule
