Gregification/cse-labs/cse3442 embedded 1/lab7/src/lab7_George_Boone.h

/*
 * lab7_George_Boone.h
 *
 *  Created on: Nov 24, 2024
 *      Author: turtl
 */

#ifndef SRC_LAB7_GEORGE_BOONE_H_
#define SRC_LAB7_GEORGE_BOONE_H_

/**
 * called when the MPC23S08 has a interrupt
 *  the external interrupt sig is read in from a gpio pin
 */
void intr_MCP23S08();


#endif /* SRC_LAB7_GEORGE_BOONE_H_ */
