Gregification/cse-labs/cse3320/lab2/part1/Entry.h

/**
 * cse3320 Assignment 2 Part 1
 * George Boone
 * 1002055713
 * 
 */

#ifndef ENTRY_H
#define ENTRY_H

typedef struct {
    long id;
    char genome[26]; // at least thats what I this data is
} ENTRY;

#endif // ENTRY_H
