Gregification/cse-labs/cse3341 digital logic design 2/dld2_lab3/FullAdder.sv

/**
cse3341, digital logic 2, lab 3
George Boone
1002055713

this really should be named GCLA2 not FullAdder. It just a hassle to track down all the names to change

*/

module FullAdder(
	input A,		//a bit
	input B,		//a bit
	input Cin,	//carry in
	
	output S,		//sum
	output Cout,	//carry out
	output G,		//generate
	output P			//propagate, xor
);
	logic AxB;
	
	assign AxB = A ^ B;
 
	assign G = A & B;
	assign P = AxB;
	assign S = P ^ Cin;
	assign Cout = G | (P & Cin); 
	
endmodule
