Gregification/cse-labs/(commit log)

2024-08-26 Update Bin2seven.sv
    formatting bug
    [Bin2seven.sv]
2024-09-04 bug with scroll menu
    [main.c, tm4c123gh6pm_startup_ccs.c]
2024-09-05 complete lab 2
    [main.obj, wait.obj]
2024-09-09 embeded1, complete lab 2, forgot to push
    [main.obj]
2024-09-11 kicad training
    [digikeytraning.kicad_pcb, digikeytraning.kicad_sch]
2024-09-12 lot simpiler than i though
    [digikeytraning.kicad_pcb, digikeytraning.kicad_sch]
2024-09-14 renamed homelab folder to be more approate
    [digikeytraning.kicad_pcb, digikeytraning.kicad_sch]
2024-09-20 complete cse3442 lab3
    [clock.obj, lab3a_GeorgeBoone.obj, lab3a_GeorgeBoone_s.obj, lab3b_GeorgeBoone.obj, uart0.obj]
2024-09-22 ccs really hates git repos
    [clock.obj, handler_root.obj, main.obj, uart0.obj]
2024-09-22 git cach reset
    [clock.obj, handler_root.obj, main.obj, uart0.obj, wait.obj]
2024-09-26 working adder, fails if a and b are the same though
    [ConditionCodeLogic.sv, FullAdder.sv, GroupCarryLookaheadAdder.sv, lab3.sv]
2024-09-27 report materials
2024-09-29 speed it up losh
    [attiny_rf_vsense.kicad_pcb, attiny_rf_vsense.kicad_sch]
2024-10-06 working attiny85 spi slave
2024-10-06 bricked the att fuses
2024-10-06 complete lab4
    [clock.obj, lab3a_GeorgeBoone.obj, lab3a_GeorgeBoone_s.obj]
2024-10-10 verilog hell, arth shifting is apparently too much
    [ControlUnit.sv, SignedMultiplier_ShiftAdd_4x4.sv, lab4.sv]
2024-10-12 unsigned thingy
    [c5_pin_model_dump.txt]
2024-10-20 os : lab 2, complete part 1
    [data.csv, sorted.csv]
2024-10-20 cse3320 : complete lab 2
    [data.csv, sorted.csv]
2024-10-25 tests for lab 5
    [clock.obj, lab5_GeorgeBoone.obj, uart0.obj]
2024-10-25 cse3442 complete lab 5
    [clock.obj, lab5_GeorgeBoone.obj, uart0.obj]
2024-11-02 finalized ic selection
    incomplete boost converter circuit
    [attiny85_hvsp.kicad_sch]
2024-11-03 finalized 2 stage bjt v stepper. fet would have been better but gotta use these bjts for something
    [attiny85_hvsp.kicad_pcb, attiny85_hvsp.kicad_sch]
2024-11-03 maybe final pcb layout
    [attiny85_hvsp.kicad_pcb]
2024-11-03 forgot ot push schematic
    [attiny85_hvsp.kicad_sch]
2024-11-06 maybe milable hvsp pcb
    [attiny85_hvsp.kicad_pcb]
2024-11-08 removed teardrops and properly sized thermal reliefs
    [attiny85_hvsp.kicad_pcb]
2024-11-11 complete C and R
    [clock.obj, lab5_GeorgeBoone.obj, uart0.obj]
2024-11-17 maybe bantam safe layout
    [attiny85_hvsp.kicad_pcb, attiny85_hvsp.kicad_sch]
2024-11-17 bantam friendly layout
    [attiny85_hvsp.kicad_pcb, attiny85_hvsp.kicad_sch]
2024-11-25 corrected lab folder name
    [MCP23S08_support.h, lab7_George_Boone.c, lab7_George_Boone.h, tm4c123gh6pm_startup_ccs.c, uart0.c, uart0.h]
2024-11-25 bad spi thing, i hate the docs
2024-11-26 exact match of footprint found
2024-12-01 who ever made the supplied pin assignments are evil
2024-12-01 working adder, buggy raw iput mode though
    [F32AdderSubtractor.sv]
2024-12-01 working subtractor, however, signbit correct but not displaying
    [F32AdderSubtractor.sv, LCD.sv, dld2_termProject.sv]
2024-12-01 complete subtractor
    bug: sign bit is set but display does not show it
    missing raw binary display
    [F32AdderSubtractor.sv, dld2_termProject.sv]
2024-12-14 working tiny85 high fuse resetter on TM4c123G
    [main.c]
2025-01-05 git ignore hel
    [attiny85_hvsp.kicad_pcb, attiny85_hvsp.kicad_sch, clock.obj, cmdhandler.obj, global_handlers.obj, handler_help.obj, handler_root.obj, lab3a_GeorgeBoone.obj]
2025-02-08 now able to compile to cortex-M4+ . yippie!
    all i did was add some extra compiler flags CCS wasent able to generate for some reason. see msp0l11306fiddle/notes folder for info
    [reg_dump.csv]
2025-02-08 backup. incomplete uart test
2025-02-10 cse4352 ex stage. most tests implimented, passing all
2025-02-12 is37 stuff
    [IS37SML01G1.kicad_pcb, IS37SML01G1.kicad_sch]
2025-02-16 corrected missinf IRQ vector
    [eth0.c, eth0.h, ethernet.c, gpio.c, gpio.h, main.c, tm4c123gh6pm_startup_ccs.c, uart0.c]
2025-02-19 ip checksum offset issue
    [eth0.h, ethernet.c, tcp.c, tcp.h]
2025-02-26 corrected rrected auto loopback
    [arp.c, arp.h, env.c, env.h, ethernet.c, mqtt.c, mqtt.h, socket.c]
2025-02-27 removed client sent keep alive. now failing during closing
    [ethernet.c, mqtt.c, mqtt.h, tcp.c, tcp.h]
2025-03-01 more failed debugging ...
    [mqtt.c, tcp.c]
2025-03-10 corrected string termination bug
    [ethernet.c, mqtt.c, tcp.c]
2025-03-11 removed dynamic memory code, worse design but it works
    unable to determine why mem allocatating fails
    [tcp.c]
2025-03-16 apparently this crashes in debug mode
    [IS37SML01G1.kicad_pcb, IS37SML01G1.kicad_sch, attiny_rf_vsense.kicad_pcb, attiny_rf_vsense.kicad_sch, c5_pin_model_dump.txt, clock.obj, cmdhandler.obj, data.csv]
2025-03-16 git exploding
    [IS37SML01G1.kicad_pcb, IS37SML01G1.kicad_sch, attiny_rf_vsense.kicad_pcb, attiny_rf_vsense.kicad_sch, c5_pin_model_dump.txt, clock.obj, data.csv, digikeytraning.kicad_pcb]
2025-03-16 msp0l uart tx working
2025-03-18 corrected uart rx error
    aaaaahhhhhhhhhhhhhhh should have caught htis immideatly but noo
    [main.cpp]
2025-03-19 maybe working spi
2025-03-20 spi but cs reg latching
2025-03-22 updated adc dumper
2025-03-24 adc somewhat works on reboot
    [main.cpp]
2025-03-25 reolved one shot problem with ACD
    [main.cpp]
2025-03-25 figured out spi
2025-03-26 lacking adc mem addrs
2025-03-27 corrected pipeline buffers
    determined and noted how DLADC12 register priority is set up
    [lab6.sv, main.cpp]
2025-03-27 10channel v sensor
2025-04-02 me is behind :(
    [IS37SML01G1.kicad_pcb, IS37SML01G1.kicad_sch, attiny_rf_vsense.kicad_pcb, attiny_rf_vsense.kicad_sch, c5_pin_model_dump.txt, clock.obj, data.csv, digikeytraning.kicad_pcb]
2025-04-07 confimed msp spi
2025-04-08 corrected spi transfer
2025-04-09 tx/rx then swap roles and it works
    [main.c]
2025-04-11 maybe working timer
2025-04-13 working thing in general
    only bug is clients can end up occupiing the same frame if joining at the same time, maybe adding a client side min-time-before-accepting-response-from-server check would fix this
    [common.h, main.c]
2025-04-20 brute force dft/idft implimentation
    [filter.csv, response.csv]
2025-04-26 complete frameowrk, missing some packets
2025-04-27 complete load after write stalling
    [lab8.sv]
2025-04-29 corrected mqtt tpoic name
    [ethernet.c]
2025-04-29 updated weather pressure thing
2025-05-09 compiler updated itself and seems to acutall compile things now
    [project configuration.txt]
2025-05-10 maybee working rots. missing interrupt handlers though
    [main.cpp, tm4c1294ncpdt_startup_ccs.c]
2025-08-25 all but reboot
    [clock.obj, main.obj, uart0.obj]
2025-08-29 qol changes
    [main.obj]
2025-09-06 mini project registers make me sad
    [main.obj]
2025-09-12 pendsv pending destruction
    cant get it or MPU handlers to trigger. probably missing some reg somewhere
    [common.c, common.h, main.c, rtos.c, rtos.h, tm4c123gh6pm_startup_ccs.c]
2025-09-16 re-figured out pwm
2025-09-25 buttoned up
2025-09-30 adc losh
2025-10-07 5 button inputs in a row
2025-10-14 bad wiring or something??
2025-10-19 forgot red board. cant test
2025-10-21 sleep func kills sys tick bug
    idk why that happens. worst case memory layout is cooked
    [rtos.c, tm4c123gh6pm_startup_ccs.c]
2025-10-24 semi working thing
    [c5_pin_model_dump.txt, clock.obj, stop_go.obj]
2025-10-25 pendsv maybe working. off byy 1 somewhere ?
    [common.obj, rtos_asm.obj, tm4c123gh6pm_startup_ccs.obj]
2025-11-14 priority scheduler & pendSv adjustment
    shuffled the fake stack stuff over to pendSV
    [common.obj, tm4c123gh6pm_startup_ccs.obj]
2025-11-15 removed lower stack MPU allowance default
    [rtos_asm.obj]
2025-11-15 software fix for btn 0
    [common.obj]
2025-11-15 windows crashing :(
    [common.obj, main.obj]
2025-11-15 theyre forcing me to write assembly D:
2025-11-18 global sram mask for current task
2025-11-19 corrected switching from global access mask
    PB output for 0d16 died. probably loose wire
2025-11-28 svic register leak fixed. stoped createThread ram access from changing
    meow meow
    [common.obj]
2025-12-02 andrew approved rtos thingy
    [common.obj, tm4c123gh6pm_startup_ccs.obj]
2025-12-02 fixed pc7
    board issue. replaced the board
2025-12-02 removed debug prints
2026-02-21 stepper steps. yippie
2026-03-23 working spi
