Gregification/cse-labs/(notices)

Notices in the files:
homelab/kicad/digikeytraning/digikeytraning.kicad_sch:
creativecommons.org/licenses/by/4.0
license cc by 4.0
